crh2007530/fpga-multitimbral-instrument/FPGA/assets/ship_source.png

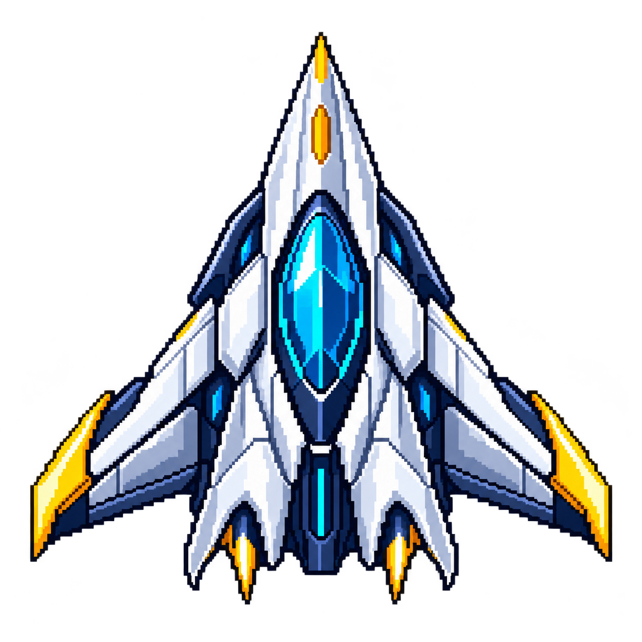
FPGA/assets/ship_source.png
