crh2007530/fpga-multitimbral-instrument/FPGA/rtl/approved_control_rom.v

module approved_control_rom(input clk,input ena,enb,input[9:0] ca,cb,pa,pb,output[31:0] qa,qb,output[15:0] pqa,pqb);
`ifdef __ICARUS__
`ifndef NATIVE_DPB
reg[31:0] curves[0:1023],ra,rb;reg[15:0] pitch[0:1023],rpa,rpb;
initial begin $readmemh("assets/approved_envelopes.hex",curves);$readmemh("assets/approved_pitch_index.hex",pitch);end
always @(posedge clk)begin if(ena)begin ra<=curves[ca];rpa<=pitch[pa];end if(enb)begin rb<=curves[cb];rpb<=pitch[pb];end end
assign qa=ra;assign qb=rb;assign pqa=rpa;assign pqb=rpb;
`else
`define APPROVED_CONTROL_NATIVE
`endif
`else
`define APPROVED_CONTROL_NATIVE
`endif
`ifdef APPROVED_CONTROL_NATIVE
DPB #(.READ_MODE0(0),.READ_MODE1(0),.BIT_WIDTH_0(16),.BIT_WIDTH_1(16),
.INIT_RAM_00(256'h40003b00370033002f002a00260022001e001900150011000d00080004000000),
.INIT_RAM_01(256'h84037f007b00770073006e006a00660062005d005900550051004c0048004400),
.INIT_RAM_02(256'hc82cc329bf27bb25b722b220ae1daa1ba618a1169d139910950e900b8c088806),
.INIT_RAM_03(256'hff4eff4cff4aff48fb46f644f242ee40ea3ee53ce139dd37d935d433d030cc2e),
.INIT_RAM_04(256'hff6bff69ff68ff66ff64ff62ff61ff5fff5dff5bff5aff58ff56ff54ff52ff50),
.INIT_RAM_05(256'hfe83fe82fe80ff7fff7dff7cff7aff79ff78ff76ff74ff73ff71ff70ff6eff6d),
.INIT_RAM_06(256'hfb97fb96fb95fb94fb92fc91fc90fc8ffc8efc8cfd8bfd8afd88fd87fe86fe84),
.INIT_RAM_07(256'hf7a8f8a7f8a6f8a5f8a4f8a3f9a2f9a1f9a0f99ff99efa9dfa9cfa9bfa99fa98),
.INIT_RAM_08(256'hf4b6f4b5f5b5f5b4f5b3f5b2f5b1f6b0f6aff6aff6aef6adf7acf7abf7aaf7a9),
.INIT_RAM_09(256'hf1c2f1c1f2c1f2c0f2bff2bff2bef3bdf3bcf3bcf3bbf3baf3b9f4b9f4b8f4b7),
.INIT_RAM_0A(256'heecceecbefcbefcaefcaefc9efc8efc8f0c7f0c7f0c6f0c5f0c5f1c4f1c3f1c3),
.INIT_RAM_0B(256'hebd4ebd4ecd3ecd3ecd2ecd2ecd1edd1edd0edd0edcfedcfedceeeceeecdeecd),
.INIT_RAM_0C(256'he8dbe9dbe9dae9dae9dae9d9ead9ead8ead8ead7ead7ead7ebd6ebd6ebd5ebd5),
.INIT_RAM_0D(256'he6e1e6e1e6e0e6e0e6e0e7dfe7dfe7dfe7dee7dee7dee8dde8dde8dce8dce8dc),
.INIT_RAM_0E(256'he3e6e3e6e3e5e3e5e4e5e4e5e4e4e4e4e4e4e5e3e5e3e5e3e5e2e5e2e5e2e6e1),
.INIT_RAM_0F(256'he0eae1eae1eae1e9e1e9e1e9e1e9e2e8e2e8e2e8e2e8e2e7e2e7e3e7e3e6e3e6),
.INIT_RAM_10(256'hc0fec2fdc4fdc6fdc8fccafbccfbcefad0f9d2f8d4f6d6f5d9f3dbf0deeee0ea),
.INIT_RAM_11(256'haaffabffacffadffafffb0ffb1ffb3ffb4ffb5ffb7ffb8febafebbfebdfebffe),
.INIT_RAM_12(256'h9bff9cff9dff9dff9eff9fffa0ffa1ffa2ffa3ffa4ffa5ffa6ffa7ffa8ffa9ff),
.INIT_RAM_13(256'h92ff92ff93ff93ff94ff94ff95ff95ff96ff96ff97ff98ff98ff99ff9aff9aff),
.INIT_RAM_14(256'h8bff8cff8cff8cff8dff8dff8dff8eff8eff8eff8fff8fff90ff90ff91ff91ff),
.INIT_RAM_15(256'h87ff87ff88ff88ff88ff88ff89ff89ff89ff89ff8aff8aff8aff8aff8bff8bff),
.INIT_RAM_16(256'h85ff85ff85ff85ff85ff85ff85ff86ff86ff86ff86ff86ff86ff87ff87ff87ff),
.INIT_RAM_17(256'h83ff83ff83ff83ff83ff83ff83ff83ff84ff84ff84ff84ff84ff84ff84ff84ff),
.INIT_RAM_18(256'h82ff82ff82ff82ff82ff82ff82ff82ff82ff82ff82ff82ff82ff83ff83ff83ff),
.INIT_RAM_19(256'h81ff81ff81ff81ff81ff81ff81ff81ff81ff81ff81ff81ff81ff81ff82ff82ff),
.INIT_RAM_1A(256'h80ff80ff80ff80ff81ff81ff81ff81ff81ff81ff81ff81ff81ff81ff81ff81ff),
.INIT_RAM_1B(256'h80ff80ff80ff80ff80ff80ff80ff80ff80ff80ff80ff80ff80ff80ff80ff80ff),
.INIT_RAM_1C(256'h80ff80ff80ff80ff80ff80ff80ff80ff80ff80ff80ff80ff80ff80ff80ff80ff),
.INIT_RAM_1D(256'h80ff80ff80ff80ff80ff80ff80ff80ff80ff80ff80ff80ff80ff80ff80ff80ff),
.INIT_RAM_1E(256'h80ff80ff80ff80ff80ff80ff80ff80ff80ff80ff80ff80ff80ff80ff80ff80ff),
.INIT_RAM_1F(256'h80ff80ff80ff80ff80ff80ff80ff80ff80ff80ff80ff80ff80ff80ff80ff80ff),
.INIT_RAM_20(256'h80ff80ff80ff80ff80ff80ff80ff80ff80ff80ff80ff80ff80ff80ff80ff80ff),
.INIT_RAM_21(256'h80ff80ff80ff80ff80ff80ff80ff80ff80ff80ff80ff80ff80ff80ff80ff80ff),
.INIT_RAM_22(256'h80ff80ff80ff80ff80ff80ff80ff80ff80ff80ff80ff80ff80ff80ff80ff80ff),
.INIT_RAM_23(256'h80ff80ff80ff80ff80ff80ff80ff80ff80ff80ff80ff80ff80ff80ff80ff80ff),
.INIT_RAM_24(256'h80ff80ff80ff80ff80ff80ff80ff80ff80ff80ff80ff80ff80ff80ff80ff80ff),
.INIT_RAM_25(256'h80ff80ff80ff80ff80ff80ff80ff80ff80ff80ff80ff80ff80ff80ff80ff80ff),
.INIT_RAM_26(256'h80ff80ff80ff80ff80ff80ff80ff80ff80ff80ff80ff80ff80ff80ff80ff80ff),
.INIT_RAM_27(256'h80ff80ff80ff80ff80ff80ff80ff80ff80ff80ff80ff80ff80ff80ff80ff80ff),
.INIT_RAM_28(256'h80ff80ff80ff80ff80ff80ff80ff80ff80ff80ff80ff80ff80ff80ff80ff80ff),
.INIT_RAM_29(256'h80ff80ff80ff80ff80ff80ff80ff80ff80ff80ff80ff80ff80ff80ff80ff80ff),
.INIT_RAM_2A(256'h80ff80ff80ff80ff80ff80ff80ff80ff80ff80ff80ff80ff80ff80ff80ff80ff),
.INIT_RAM_2B(256'h80ff80ff80ff80ff80ff80ff80ff80ff80ff80ff80ff80ff80ff80ff80ff80ff),
.INIT_RAM_2C(256'h80ff80ff80ff80ff80ff80ff80ff80ff80ff80ff80ff80ff80ff80ff80ff80ff),
.INIT_RAM_2D(256'h80ff80ff80ff80ff80ff80ff80ff80ff80ff80ff80ff80ff80ff80ff80ff80ff),
.INIT_RAM_2E(256'h80ff80ff80ff80ff80ff80ff80ff80ff80ff80ff80ff80ff80ff80ff80ff80ff),
.INIT_RAM_2F(256'h80ff80ff80ff80ff80ff80ff80ff80ff80ff80ff80ff80ff80ff80ff80ff80ff),
.INIT_RAM_30(256'h80ff80ff80ff80ff80ff80ff80ff80ff80ff80ff80ff80ff80ff80ff80ff80ff),
.INIT_RAM_31(256'h80ff80ff80ff80ff80ff80ff80ff80ff80ff80ff80ff80ff80ff80ff80ff80ff),
.INIT_RAM_32(256'h80ff80ff80ff80ff80ff80ff80ff80ff80ff80ff80ff80ff80ff80ff80ff80ff),
.INIT_RAM_33(256'h80ff80ff80ff80ff80ff80ff80ff80ff80ff80ff80ff80ff80ff80ff80ff80ff),
.INIT_RAM_34(256'h80ff80ff80ff80ff80ff80ff80ff80ff80ff80ff80ff80ff80ff80ff80ff80ff),
.INIT_RAM_35(256'h80ff80ff80ff80ff80ff80ff80ff80ff80ff80ff80ff80ff80ff80ff80ff80ff),
.INIT_RAM_36(256'h80ff80ff80ff80ff80ff80ff80ff80ff80ff80ff80ff80ff80ff80ff80ff80ff),
.INIT_RAM_37(256'h80ff80ff80ff80ff80ff80ff80ff80ff80ff80ff80ff80ff80ff80ff80ff80ff),
.INIT_RAM_38(256'h80ff80ff80ff80ff80ff80ff80ff80ff80ff80ff80ff80ff80ff80ff80ff80ff),
.INIT_RAM_39(256'h80ff80ff80ff80ff80ff80ff80ff80ff80ff80ff80ff80ff80ff80ff80ff80ff),
.INIT_RAM_3A(256'h80ff80ff80ff80ff80ff80ff80ff80ff80ff80ff80ff80ff80ff80ff80ff80ff),
.INIT_RAM_3B(256'h80ff80ff80ff80ff80ff80ff80ff80ff80ff80ff80ff80ff80ff80ff80ff80ff),
.INIT_RAM_3C(256'h80ff80ff80ff80ff80ff80ff80ff80ff80ff80ff80ff80ff80ff80ff80ff80ff),
.INIT_RAM_3D(256'h80ff80ff80ff80ff80ff80ff80ff80ff80ff80ff80ff80ff80ff80ff80ff80ff),
.INIT_RAM_3E(256'h80ff80ff80ff80ff80ff80ff80ff80ff80ff80ff80ff80ff80ff80ff80ff80ff),
.INIT_RAM_3F(256'h80ff80ff80ff80ff80ff80ff80ff80ff80ff80ff80ff80ff80ff80ff80ff80ff)) rom_lo(.DOA(qa[15:0]),.DOB(qb[15:0]),.DIA(16'd0),.DIB(16'd0),.BLKSELA(3'd0),.BLKSELB(3'd0),.ADA({ca,4'd0}),.ADB({cb,4'd0}),.WREA(1'b0),.WREB(1'b0),.CLKA(clk),.CLKB(clk),.CEA(ena),.CEB(enb),.OCEA(1'b1),.OCEB(1'b1),.RESETA(1'b0),.RESETB(1'b0));
DPB #(.READ_MODE0(0),.READ_MODE1(0),.BIT_WIDTH_0(16),.BIT_WIDTH_1(16),
.INIT_RAM_00(256'hff7fff77ff6eff66ff5dff55ff4cff44ff3bff33ff2aff22ff19ff11ff08ff00),
.INIT_RAM_01(256'hfffffffffff6ffeeffe5ffddffd4ffccffc3ffbbffb2ffaaffa1ff99ff90ff88),
.INIT_RAM_02(256'hfdfffdfffdfffdfffdfffefffefffefffefffefffefffefffeffffffffffffff),
.INIT_RAM_03(256'hfbfffbfffbfffbfffcfffcfffcfffcfffcfffcfffcfffcfffcfffdfffdfffdff),
.INIT_RAM_04(256'hf9fdf9fdf9fdf9fdfafdfafdfafefafefafefafefafefafefbfefbfefbfefbff),
.INIT_RAM_05(256'hf7fbf7fbf7fbf8fcf8fcf8fcf8fcf8fcf8fcf8fcf8fcf9fcf9fdf9fdf9fdf9fd),
.INIT_RAM_06(256'hf5faf5faf6faf6faf6faf6faf6faf6faf6faf6faf7fbf7fbf7fbf7fbf7fbf7fb),
.INIT_RAM_07(256'hf4f8f4f8f4f8f4f8f4f8f4f8f4f8f4f9f4f9f5f9f5f9f5f9f5f9f5f9f5f9f5f9),
.INIT_RAM_08(256'hf2f6f2f6f2f6f2f6f2f7f2f7f2f7f2f7f3f7f3f7f3f7f3f7f3f7f3f7f3f8f3f8),
.INIT_RAM_09(256'hf0f4f0f5f0f5f0f5f0f5f0f5f1f5f1f5f1f5f1f5f1f5f1f6f1f6f1f6f1f6f2f6),
.INIT_RAM_0A(256'heef3eef3eef3eef3eef3eff3eff3eff4eff4eff4eff4eff4eff4eff4f0f4f0f4),
.INIT_RAM_0B(256'hecf1ecf1ecf1edf1edf2edf2edf2edf2edf2edf2edf2edf2eef2eef2eef3eef3),
.INIT_RAM_0C(256'heaf0ebf0ebf0ebf0ebf0ebf0ebf0ebf0ebf0ebf0ecf1ecf1ecf1ecf1ecf1ecf1),
.INIT_RAM_0D(256'he9eee9eee9eee9eee9eee9eee9eee9efeaefeaefeaefeaefeaefeaefeaefeaef),
.INIT_RAM_0E(256'he7ece7ece7ece7ede7ede7ede8ede8ede8ede8ede8ede8ede8ede8eee8eee9ee),
.INIT_RAM_0F(256'he5ebe5ebe5ebe5ebe6ebe6ebe6ebe6ebe6ebe6ece6ece6ece6ece7ece7ece7ec),
.INIT_RAM_10(256'hccd4ced5cfd7d1d8d3dad4dbd6ddd7ded9e0dbe1dce3dee4e0e6e2e7e3e9e5eb),
.INIT_RAM_11(256'hb5bfb6c0b8c1b9c2bac4bcc5bdc6bfc8c0c9c2cac3ccc5cdc6cec8d0c9d1cbd3),
.INIT_RAM_12(256'ha0aca1ada3aea4afa5b0a6b1a8b3a9b4aab5abb6adb7aeb8afbab1bbb2bcb4bd),
.INIT_RAM_13(256'h8e9b8f9c909d919e929f93a094a196a297a398a499a59aa69ba79da89ea99fab),
.INIT_RAM_14(256'h7e8c7e8d7f8e808f819082918391849285938694879588968a978b988c998d9a),
.INIT_RAM_15(256'h6f7f708071817281738273837484758576857786788779887a897b8a7c8a7d8b),
.INIT_RAM_16(256'h627363746475657565766677677868786979697a6a7a6b7b6c7c6d7d6d7d6e7e),
.INIT_RAM_17(256'h5769586a586a596b5a6b5a6c5b6d5c6d5d6e5d6f5e6f5f705f71607161726273),
.INIT_RAM_18(256'h4d604e604e614f624f6250635163516452645365536554665467556756685668),
.INIT_RAM_19(256'h4458455845594659465a475a475b485b495c495c4a5d4a5d4b5e4b5e4c5f4d5f),
.INIT_RAM_1A(256'h3c513d513d523e523e523f533f53405440544155415542564256435643574457),
.INIT_RAM_1B(256'h364a364b364b374b374c384c384d384d394d394e3a4e3a4f3b4f3b4f3c503c50),
.INIT_RAM_1C(256'h2f453045304530463146314632473247324733483348344934493449354a354a),
.INIT_RAM_1D(256'h2a402a402b402b412b412c412c422c422d422d432d432e432e432e442f442f44),
.INIT_RAM_1E(256'h253b253c263c263c263c273d273d273d273e283e283e283e293f293f293f2a40),
.INIT_RAM_1F(256'h213821382138223822382239223923392339233a233a243a243a243b253b253b),
.INIT_RAM_20(256'h1d341d341e341e351e351e351e351f361f361f361f3620362037203720372137),
.INIT_RAM_21(256'h1a311a311a311a321b321b321b321b321b331c331c331c331c331c331d341d34),
.INIT_RAM_22(256'h172e172e172f172f182f182f182f182f18301830193019301930193019311a31),
.INIT_RAM_23(256'h142c142c152c152c152d152d152d152d152d162d162d162e162e162e162e172e),
.INIT_RAM_24(256'h122a122a122a122a122a132a132b132b132b132b132b132b142b142c142c142c),
.INIT_RAM_25(256'h10281028102810281028102911291129112911291129112911291129122a122a),
.INIT_RAM_26(256'h0e260e260e260e270e270f270f270f270f270f270f270f270f280f2810281028),
.INIT_RAM_27(256'h0c250d250d250d250d250d250d250d250d260d260d260d260e260e260e260e26),
.INIT_RAM_28(256'h0b240b240b240b240b240b240c240c240c240c240c240c240c240c250c250c25),
.INIT_RAM_29(256'h0a220a220a230a230a230a230a230a230a230a230a230b230b230b230b230b23),
.INIT_RAM_2A(256'h09210921092109220922092209220922092209220922092209220a220a220a22),
.INIT_RAM_2B(256'h0820082108210821082108210821082108210821082108210821082108210921),
.INIT_RAM_2C(256'h0720072007200720072007200720072007200720072007200720072008200820),
.INIT_RAM_2D(256'h061f061f061f061f061f061f061f061f061f061f061f061f071f072007200720),
.INIT_RAM_2E(256'h051e051e051e051e051e051f061f061f061f061f061f061f061f061f061f061f),
.INIT_RAM_2F(256'h051e051e051e051e051e051e051e051e051e051e051e051e051e051e051e051e),
.INIT_RAM_30(256'h041d041d041d041d041d041d041d041d041e041e041e051e051e051e051e051e),
.INIT_RAM_31(256'h041d041d041d041d041d041d041d041d041d041d041d041d041d041d041d041d),
.INIT_RAM_32(256'h031c031c031d031d031d031d031d031d031d031d041d041d041d041d041d041d),
.INIT_RAM_33(256'h031c031c031c031c031c031c031c031c031c031c031c031c031c031c031c031c),
.INIT_RAM_34(256'h031c031c031c031c031c031c031c031c031c031c031c031c031c031c031c031c),
.INIT_RAM_35(256'h021c021c021c021c021c021c021c021c021c021c021c021c021c021c031c031c),
.INIT_RAM_36(256'h021b021b021b021b021b021b021b021b021b021b021b021b021b021c021c021c),
.INIT_RAM_37(256'h021b021b021b021b021b021b021b021b021b021b021b021b021b021b021b021b),
.INIT_RAM_38(256'h021b021b021b021b021b021b021b021b021b021b021b021b021b021b021b021b),
.INIT_RAM_39(256'h011b011b011b011b011b011b011b011b011b011b011b021b021b021b021b021b),
.INIT_RAM_3A(256'h011b011b011b011b011b011b011b011b011b011b011b011b011b011b011b011b),
.INIT_RAM_3B(256'h011a011a011b011b011b011b011b011b011b011b011b011b011b011b011b011b),
.INIT_RAM_3C(256'h011a011a011a011a011a011a011a011a011a011a011a011a011a011a011a011a),
.INIT_RAM_3D(256'h011a011a011a011a011a011a011a011a011a011a011a011a011a011a011a011a),
.INIT_RAM_3E(256'h011a011a011a011a011a011a011a011a011a011a011a011a011a011a011a011a),
.INIT_RAM_3F(256'h011a011a011a011a011a011a011a011a011a011a011a011a011a011a011a011a)) rom_hi(.DOA(qa[31:16]),.DOB(qb[31:16]),.DIA(16'd0),.DIB(16'd0),.BLKSELA(3'd0),.BLKSELB(3'd0),.ADA({ca,4'd0}),.ADB({cb,4'd0}),.WREA(1'b0),.WREB(1'b0),.CLKA(clk),.CLKB(clk),.CEA(ena),.CEB(enb),.OCEA(1'b1),.OCEB(1'b1),.RESETA(1'b0),.RESETB(1'b0));
DPB #(.READ_MODE0(0),.READ_MODE1(0),.BIT_WIDTH_0(16),.BIT_WIDTH_1(16),
.INIT_RAM_00(256'h020502300263029e02e4033a03a3042804d405bc070208ea0c0d120c21507c80),
.INIT_RAM_01(256'h00dd00e600ef00f901040110011d012b013a014b015d0172018901a201bf01e0),
.INIT_RAM_02(256'h0087008a008e00920096009a009f00a300a800ae00b300b900bf00c600cd00d5),
.INIT_RAM_03(256'h005f00610063006500670069006b006e0070007200750078007a007d00800084),
.INIT_RAM_04(256'h0049004a004b004c004d004f0050005100530054005500570059005a005c005d),
.INIT_RAM_05(256'h003a003b003c003d003d003e003f004000410042004300440045004600470048),
.INIT_RAM_06(256'h003000310032003200330033003400340035003600360037003800380039003a),
.INIT_RAM_07(256'h0029002a002a002a002b002b002c002c002d002d002e002e002e002f002f0030),
.INIT_RAM_08(256'h0024002400240025002500250026002600260027002700270028002800280029),
.INIT_RAM_09(256'h0020002000200020002100210021002100220022002200220023002300230024),
.INIT_RAM_0A(256'h001c001c001d001d001d001d001d001e001e001e001e001e001f001f001f001f),
.INIT_RAM_0B(256'h00190019001a001a001a001a001a001a001b001b001b001b001b001c001c001c),
.INIT_RAM_0C(256'h0017001700170017001800180018001800180018001800190019001900190019),
.INIT_RAM_0D(256'h0015001500150015001600160016001600160016001600160016001700170017),
.INIT_RAM_0E(256'h0013001300140014001400140014001400140014001400140015001500150015),
.INIT_RAM_0F(256'h0012001200120012001200120012001300130013001300130013001300130013),
.INIT_RAM_10(256'h0011001100110011001100110011001100110011001100120012001200120012),
.INIT_RAM_11(256'h0010001000100010001000100010001000100010001000100010001000110011),
.INIT_RAM_12(256'h000f000f000f000f000f000f000f000f000f000f000f000f000f000f000f000f),
.INIT_RAM_13(256'h000e000e000e000e000e000e000e000e000e000e000e000e000e000e000e000f),
.INIT_RAM_14(256'h000d000d000d000d000d000d000d000d000d000d000d000d000d000e000e000e),
.INIT_RAM_15(256'h000c000c000c000c000c000c000c000d000d000d000d000d000d000d000d000d),
.INIT_RAM_16(256'h000c000c000c000c000c000c000c000c000c000c000c000c000c000c000c000c),
.INIT_RAM_17(256'h000b000b000b000b000b000b000b000b000b000b000b000b000b000b000c000c),
.INIT_RAM_18(256'h000a000b000b000b000b000b000b000b000b000b000b000b000b000b000b000b),
.INIT_RAM_19(256'h000a000a000a000a000a000a000a000a000a000a000a000a000a000a000a000a),
.INIT_RAM_1A(256'h000a000a000a000a000a000a000a000a000a000a000a000a000a000a000a000a),
.INIT_RAM_1B(256'h00090009000900090009000900090009000900090009000900090009000a000a),
.INIT_RAM_1C(256'h0009000900090009000900090009000900090009000900090009000900090009),
.INIT_RAM_1D(256'h0008000800080008000900090009000900090009000900090009000900090009),
.INIT_RAM_1E(256'h0008000800080008000800080008000800080008000800080008000800080008),
.INIT_RAM_1F(256'h0008000800080008000800080008000800080008000800080008000800080008),
.INIT_RAM_20(256'h0008000800080008000800080008000800080008000800080008000800080008),
.INIT_RAM_21(256'h0007000700070007000700070007000700070007000700070007000700070007),
.INIT_RAM_22(256'h0007000700070007000700070007000700070007000700070007000700070007),
.INIT_RAM_23(256'h0007000700070007000700070007000700070007000700070007000700070007),
.INIT_RAM_24(256'h0007000700070007000700070007000700070007000700070007000700070007),
.INIT_RAM_25(256'h0006000600060006000600060006000600060006000600060006000700070007),
.INIT_RAM_26(256'h0006000600060006000600060006000600060006000600060006000600060006),
.INIT_RAM_27(256'h0006000600060006000600060006000600060006000600060006000600060006),
.INIT_RAM_28(256'h0006000600060006000600060006000600060006000600060006000600060006),
.INIT_RAM_29(256'h0006000600060006000600060006000600060006000600060006000600060006),
.INIT_RAM_2A(256'h0005000500050005000600060006000600060006000600060006000600060006),
.INIT_RAM_2B(256'h0005000500050005000500050005000500050005000500050005000500050005),
.INIT_RAM_2C(256'h0005000500050005000500050005000500050005000500050005000500050005),
.INIT_RAM_2D(256'h0005000500050005000500050005000500050005000500050005000500050005),
.INIT_RAM_2E(256'h0005000500050005000500050005000500050005000500050005000500050005),
.INIT_RAM_2F(256'h0005000500050005000500050005000500050005000500050005000500050005),
.INIT_RAM_30(256'h0005000500050005000500050005000500050005000500050005000500050005),
.INIT_RAM_31(256'h0005000500050005000500050005000500050005000500050005000500050005),
.INIT_RAM_32(256'h0004000400040004000400040004000400050005000500050005000500050005),
.INIT_RAM_33(256'h0004000400040004000400040004000400040004000400040004000400040004),
.INIT_RAM_34(256'h0004000400040004000400040004000400040004000400040004000400040004),
.INIT_RAM_35(256'h0004000400040004000400040004000400040004000400040004000400040004),
.INIT_RAM_36(256'h0004000400040004000400040004000400040004000400040004000400040004),
.INIT_RAM_37(256'h0004000400040004000400040004000400040004000400040004000400040004),
.INIT_RAM_38(256'h0004000400040004000400040004000400040004000400040004000400040004),
.INIT_RAM_39(256'h0004000400040004000400040004000400040004000400040004000400040004),
.INIT_RAM_3A(256'h0004000400040004000400040004000400040004000400040004000400040004),
.INIT_RAM_3B(256'h0004000400040004000400040004000400040004000400040004000400040004),
.INIT_RAM_3C(256'h0004000400040004000400040004000400040004000400040004000400040004),
.INIT_RAM_3D(256'h0004000400040004000400040004000400040004000400040004000400040004),
.INIT_RAM_3E(256'h0003000300030003000300030003000300030003000300030004000400040004),
.INIT_RAM_3F(256'h0003000300030003000300030003000300030003000300030003000300030003)) rom_pitch(.DOA(pqa),.DOB(pqb),.DIA(16'd0),.DIB(16'd0),.BLKSELA(3'd0),.BLKSELB(3'd0),.ADA({pa,4'd0}),.ADB({pb,4'd0}),.WREA(1'b0),.WREB(1'b0),.CLKA(clk),.CLKB(clk),.CEA(ena),.CEB(enb),.OCEA(1'b1),.OCEB(1'b1),.RESETA(1'b0),.RESETB(1'b0));
`undef APPROVED_CONTROL_NATIVE
`endif
endmodule
