crh2007530/fpga-multitimbral-instrument/FPGA/rtl/approved_wave_rom.v

// Exact dual-port oscillator table, generated from approved_oscillators.hex.
module approved_wave_rom(input clk, input ena,enb,input[12:0] addra,addrb,output[15:0] qa,qb);
`ifdef __ICARUS__
`ifndef NATIVE_DPB
reg[15:0] mem[0:8191],ra,rb;
initial $readmemh("assets/approved_oscillators.hex",mem);
always @(posedge clk)begin if(ena)ra<=mem[addra];if(enb)rb<=mem[addrb];end
assign qa=ra;assign qb=rb;
`else
`define APPROVED_NATIVE_ROM
`endif
`else
`define APPROVED_NATIVE_ROM
`endif
`ifdef APPROVED_NATIVE_ROM
wire[15:0] a[0:7],b[0:7];reg[2:0] sa,sb;
always @(posedge clk)begin if(ena)sa<=addra[12:10];if(enb)sb<=addrb[12:10];end
assign qa=a[sa];assign qb=b[sb];
DPB #( .READ_MODE0(0),.READ_MODE1(0),.BIT_WIDTH_0(16),.BIT_WIDTH_1(16),
.INIT_RAM_00(256'h0000000000000000000000000000000000000000000000000000000000000000),
.INIT_RAM_01(256'h0000000000000000000000000000000000000000000000000000000000000000),
.INIT_RAM_02(256'h0000000000000000000000000000000000000000000000000000000000000000),
.INIT_RAM_03(256'h0000000000000000000000000000000000000000000000000000000000000000),
.INIT_RAM_04(256'h0000000000000000000000000000000000000000000000000000000000000000),
.INIT_RAM_05(256'h0000000000000000000000000000000000000000000000000000000000000000),
.INIT_RAM_06(256'h0000000000000000000000000000000000000000000000000000000000000000),
.INIT_RAM_07(256'h0000000000000000000000000000000000000000000000000000000000000000),
.INIT_RAM_08(256'h0000000000000000000000000000000000000000000000000000000000000000),
.INIT_RAM_09(256'h0000000000000000000000000000000000000000000000000000000000000000),
.INIT_RAM_0A(256'h0000000000000000000000000000000000000000000000000000000000000000),
.INIT_RAM_0B(256'h0000000000000000000000000000000000000000000000000000000000000000),
.INIT_RAM_0C(256'h0000000000000000000000000000000000000000000000000000000000000000),
.INIT_RAM_0D(256'h0000000000000000000000000000000000000000000000000000000000000000),
.INIT_RAM_0E(256'h0000000000000000000000000000000000000000000000000000000000000000),
.INIT_RAM_0F(256'h0000000000000000000000000000000000000000000000000000000000000000),
.INIT_RAM_10(256'h0000000000000000000000000000000000000000000000000000000000000000),
.INIT_RAM_11(256'h0000000000000000000000000000000000000000000000000000000000000000),
.INIT_RAM_12(256'h0000000000000000000000000000000000000000000000000000000000000000),
.INIT_RAM_13(256'h0000000000000000000000000000000000000000000000000000000000000000),
.INIT_RAM_14(256'h0000000000000000000000000000000000000000000000000000000000000000),
.INIT_RAM_15(256'h0000000000000000000000000000000000000000000000000000000000000000),
.INIT_RAM_16(256'h0000000000000000000000000000000000000000000000000000000000000000),
.INIT_RAM_17(256'h0000000000000000000000000000000000000000000000000000000000000000),
.INIT_RAM_18(256'h0000000000000000000000000000000000000000000000000000000000000000),
.INIT_RAM_19(256'h0000000000000000000000000000000000000000000000000000000000000000),
.INIT_RAM_1A(256'h0000000000000000000000000000000000000000000000000000000000000000),
.INIT_RAM_1B(256'h0000000000000000000000000000000000000000000000000000000000000000),
.INIT_RAM_1C(256'h0000000000000000000000000000000000000000000000000000000000000000),
.INIT_RAM_1D(256'h0000000000000000000000000000000000000000000000000000000000000000),
.INIT_RAM_1E(256'h0000000000000000000000000000000000000000000000000000000000000000),
.INIT_RAM_1F(256'h0000000000000000000000000000000000000000000000000000000000000000),
.INIT_RAM_20(256'hd130cd60c9d3c693c3aac11fbef6bd31bbcababcb9fcb97eb934b913b90fb91e),
.INIT_RAM_21(256'h11be0f120bfc088c04d000d7fcaff864f400ef8deb11e695e220ddb8d967d536),
.INIT_RAM_22(256'h039d05ee084d0ab10d0e0f57117b1368150c16561734179b177e16da15ab13f5),
.INIT_RAM_23(256'he7aee8eeea4febc9ed56eef0f093f23ff3f2f5aef775f949fb2ffd29ff380160),
.INIT_RAM_24(256'hfcdcf95bf5f8f2c0efc4ed12eab6e8bae723e5f5e52fe4cde4cae51de5bbe699),
.INIT_RAM_25(256'h256b2465232321a41feb1df91bd2197616e6142511360e1a0ad6077103f40069),
.INIT_RAM_26(256'h1b4e1cee1e741fe1213322692383247e2558260b269426ef2716270626ba2632),
.INIT_RAM_27(256'h0131020a03110444059d071a08b80a720c430e271016120b13ff15eb17c91996),
.INIT_RAM_28(256'h1a7317601437110f0e000b1f087f062f043902a40171009e0025ffff0025008e),
.INIT_RAM_29(256'h2c192c112bf42bc72b8b2b3e2adb2a5929ad28cc27aa263d247f226d20091d5c),
.INIT_RAM_2A(256'h149b172d19b31c261e7f20b722c824ac265c27d529142a172adf2b712bd12c06),
.INIT_RAM_2B(256'h03dd0278016700b0005b006a00de01b302e6046d063e084d0a8e0cf50f761206),
.INIT_RAM_2C(256'h2eac2c2429612672236520491d2a1a13170c141b11480e960c0b09ac077f058d),
.INIT_RAM_2D(256'h30ae31d332e133dc34c0358c363a36c03716372f3700368035a7347032db30ed),
.INIT_RAM_2E(256'h1be41c271cae1d781e7f1fbc212922b92462261927d229832b232cac2e1c2f72),
.INIT_RAM_2F(256'h40853cc438e7350b31492db82a6a276c24c6227c208f1efb1dbe1cd31c381be9),
.INIT_RAM_30(256'h436545d848174a214bf04d7a4eb34f8b4ff44fde4f404e114c524a094740440c),
.INIT_RAM_31(256'h05e709a60d9e11c716171a801ef5236527c22bfb300633d9376f3ac63ddf40be),
.INIT_RAM_32(256'hf0c5efcbef0dee97ee73eea7ef34f01cf15bf2edf4cff6fbf96ffc28ff260266),
.INIT_RAM_33(256'hfb21fb71fb9afba0fb87fb4efaf3fa75f9d0f903f80ff6f6f5c1f479f32cf1eb),
.INIT_RAM_34(256'he54ce5f1e6dfe818e997eb51ed35ef31f12ff31cf4e7f683f7e5f90bf9f4faa4),
.INIT_RAM_35(256'hd8bed9c6db0cdc7dddfedf79e0d6e205e2f8e3ade424e467e488e499e4b1e4e6),
.INIT_RAM_36(256'he955e7fae68ee50fe37be1d6e027de77dcd4db4fd9fad8e4d81fd7b5d7acd807),
.INIT_RAM_37(256'h002fff20fde8fc8afb0df97cf7ddf63af49bf305f17df006ee9fed45ebf4eaa7),
.INIT_RAM_38(256'h0899078b068b05a604e5044c03db038b03570331030f02e402a5024601c0010f),
.INIT_RAM_39(256'hf575f87afb8efe99018204310690088e0a1e0b380bdd0c110be10b5c0a9609a3),
.INIT_RAM_3A(256'hdc7fde26df99e0dae1f1e2e7e3cce4b1e5a6e6bee809e992eb64ed82efe9f294),
.INIT_RAM_3B(256'hcd27cbd1cac3ca0dc9bbc9d4ca5bcb4acc9ace3bd01ed22ed457d684d8a4daa6),
.INIT_RAM_3C(256'hdd42dcabdc2edbc2db5adaebda66d9c0d8edd7e9d6b1d549d3b9d20fd05bceb1),
.INIT_RAM_3D(256'he8dde8e4e8cee898e83ce7b8e70ce639e545e436e317e1f3e0d4dfc5decfddf8),
.INIT_RAM_3E(256'hd39dd69ed977dc17de74e087e24fe3cbe503e5fee6c6e763e7dee83fe888e8bd),
.INIT_RAM_3F(256'hb93db96ab9a7b9feba76bb1cbbfbbd20be92c056c26ec4d4c77fca61cd6ad084)) rom0(.DOA(a[0]),.DOB(b[0]),.DIA(16'd0),.DIB(16'd0),
.BLKSELA(3'd0),.BLKSELB(3'd0),.ADA({addra[9:0],4'd0}),.ADB({addrb[9:0],4'd0}),
.WREA(1'b0),.WREB(1'b0),.CLKA(clk),.CLKB(clk),.CEA(ena && addra[12:10]==3'd0),.CEB(enb && addrb[12:10]==3'd0),
.OCEA(1'b1),.OCEB(1'b1),.RESETA(1'b0),.RESETB(1'b0));
DPB #( .READ_MODE0(0),.READ_MODE1(0),.BIT_WIDTH_0(16),.BIT_WIDTH_1(16),
.INIT_RAM_00(256'hc2d4be16b9a1b581b1c0ae66ab76a8f2a6d9a523a3c9a2c0a1fda176a121a0f9),
.INIT_RAM_01(256'h14f311660d5308cf03edfec3f963f3dfee44e89fe2fadd5dd7cfd258cd00c7d1),
.INIT_RAM_02(256'h09270b860deb105212b51507173619301adf1c2a1cfc1d411ce91beb1a4017eb),
.INIT_RAM_03(256'he242e415e62de87feafbed95f040f2f0f59cf83dfacefd4dffbc021d047706ce),
.INIT_RAM_04(256'hfac8f6ddf314ef7aec1be905e644e3e3e1ebe064df51deb6de91dee0df9de0c1),
.INIT_RAM_05(256'h3352315f2f062c51294c260422841ed81b0b172313290f200b0d06f502ddfecc),
.INIT_RAM_06(256'h24a226f0291f2b332d2d2f0a30c8326133cb34fb35e6367e36b7368835e934d7),
.INIT_RAM_07(256'hff7e007601bd0350052b074909a30c2e0ee211b0148d176b1a401d021fab2236),
.INIT_RAM_08(256'h21571d4a192e151e11360d8d0a37074304bb02a400ffffc8fefbfe93fe89fed9),
.INIT_RAM_09(256'h37a43801383b3856384f382237c6372e364e3518337e31792f042c2128d92539),
.INIT_RAM_0A(256'h145e17941ad81e1e2158247927762a412cd22f1f312532e13452357e366b371f),
.INIT_RAM_0B(256'h073f057b03fc02cb01ef0171015601a4025a037904fb06db09100b900e4f1143),
.INIT_RAM_0C(256'h3d4039b935df31cc2d9c29692548214c1d8019ed1696137a10990def0b7d0941),
.INIT_RAM_0D(256'h3dfb3f3c407a41b942f844314559465e472b47aa47c44765467d450342f6405b),
.INIT_RAM_0E(256'h271a273e27c428a629db2b572d0b2ee630d732cd34b9368e384539db3b523caf),
.INIT_RAM_0F(256'h550d50dc4c7c480b43a73f683b6337a9344631402e9d2c5d2a8429102802275b),
.INIT_RAM_10(256'h58615b0e5d715f90616b62fe643e651f6590658164e463ae61db5f6d5c6f58f2),
.INIT_RAM_11(256'h06840b7c10d9168d1c8522aa28e22f11351b3ae5405a456c4a0f4e4152045561),
.INIT_RAM_12(256'hec52eb8beaf9eaa8eaa1eaeceb8eec89eddfef92f1a4f417f6eefa2efddb01f8),
.INIT_RAM_13(256'hf71cf72ff713f6d0f670f5faf56ff4d0f41cf352f271f17af071ef5eee4aed41),
.INIT_RAM_14(256'hdcefdddddf1ae0abe28de4b4e70fe984ebfaee57f084f26df406f547f632f6cb),
.INIT_RAM_15(256'hc7ddc92fcae4cce1cf09d13bd35bd54dd6fed863d97ada49dae0db55dbc2dc43),
.INIT_RAM_16(256'he214dfc0dd5fdaefd870d5e8d35ed0dfce7bcc46ca54c8bac78bc6d8c6a8c701),
.INIT_RAM_17(256'h04ff037a01bdffd1fdbcfb89f93ff6e7f489f22aefcfed7aeb2de8e6e6a2e45e),
.INIT_RAM_18(256'h0b170a7b09f4098c09450920091709200931093b0930090508ac081d07520648),
.INIT_RAM_19(256'hf60ef95dfca3ffc902bb056607b809a60b280c3c0ce50d2e0d220cd30c550bba),
.INIT_RAM_1A(256'hd3e8d5e9d7bad963daefdc6bdde8df74e120e2f7e505e750e9daeca1ef9ff2c8),
.INIT_RAM_1B(256'hbe7ebd1abc17bb88bb7abbf0bceabe5ec03cc270c4e4c77fca28cccacf53d1b5),
.INIT_RAM_1C(256'hd32cd218d12fd066cfb0cefcce39cd56cc46cb01c983c7d2c5f7c403c20dc02d),
.INIT_RAM_1D(256'he3cbe443e480e47be42fe397e2b6e18ee028de90dcd5db09d93cd781d5e4d470),
.INIT_RAM_1E(256'hc396c730ca9fcdd9d0d4d38cd600d833da2adbebdd7ddee6e02ae14be249e320),
.INIT_RAM_1F(256'ha0fba127a182a212a2dfa3f5a55aa717a930aba5ae71b18cb4e9b879bc28bfe3),
.INIT_RAM_20(256'hd569d12ecd28c962c5e4c2b5bfdbbd59bb2fb95db7e0b6b3b5d1b535b4dab4ba),
.INIT_RAM_21(256'h174a14af11b30e610ac306e302cbfe86fa1bf594f0f8ec4fe7a1e2f6de58d9d0),
.INIT_RAM_22(256'h0d540f9f11df140b161c180619be1b381c681d411dba1dc81d651c8d1b3f197d),
.INIT_RAM_23(256'hf14ff20af2f4f40bf54df6b9f84cfa02fbd8fdccffd801f9042c066c08b60b05),
.INIT_RAM_24(256'hffacfda7fbb1f9d0f80cf66cf4f5f3acf295f1b3f107f090f04ff043f06af0c4),
.INIT_RAM_25(256'h1d061bb81a4418b217061547137911a00fbd0dd20bdf09e407e105d803ca01b9),
.INIT_RAM_26(256'h1bb11c9e1d741e351ee31f7d2001206c20ba20e620ea20c220681fdc1f1c1e28),
.INIT_RAM_27(256'h0565068b07cc09250a950c190dab0f4710e612811413159417011854198e1aac),
.INIT_RAM_28(256'h03ff0325025c01ac011900aa0061003f0047007600ca014301dc029303680459),
.INIT_RAM_29(256'h142c130211d110a10f780e5b0d4b0c490b520a64097a089107a806bc05d004e4),
.INIT_RAM_2A(256'h105c11ec135c14a715cb16c3178d1824188518ae189d185417d4172216461546),
.INIT_RAM_2B(256'hfafafadbfb08fb80fc41fd46fe89000201a7036f054d073809260b0e0ce80eae),
.INIT_RAM_2C(256'h1ba918e6160c132910490d790ac3083205cc0398019bffdafe57fd16fc1afb65),
.INIT_RAM_2D(256'h2a912b132b6e2ba32bb12b952b4d2ad32a232937280b269c24e722ef20b81e48),
.INIT_RAM_2E(256'h1bd11bbd1bf11c6a1d221e111f2f206f21c52325248125d027082821291729e7),
.INIT_RAM_2F(256'h3da63ab0379f348531732e782b9f28f3267b243d223c207c1eff1dc71cd61c2f),
.INIT_RAM_30(256'h3aff3e1c40ea43644582473f4894497a49ed49e7496848704704452d42f6406e),
.INIT_RAM_31(256'hf9c2fcdb0048040308040c4010aa153619d41e74230827832bd82ffd33e93797),
.INIT_RAM_32(256'hf36cf220f0e1efc0eec9ee08ed86ed4bed5bedbbee6def75f0d2f288f497f700),
.INIT_RAM_33(256'hf2eef440f576f68ef784f852f8f4f962f998f991f94af8c6f806f712f5f4f4b8),
.INIT_RAM_34(256'hdbc5dc57dd1ede1adf4ae0aae233e3dce59be767e935eafeecbcee69f001f184),
.INIT_RAM_35(256'hdb79db5bdb4edb4ddb53db5bdb62db62db5adb4bdb37db22db13db13db2adb63),
.INIT_RAM_36(256'he7aee675e54ae42de31de21be127e042df6cdea6ddf2dd51dcc6dc50dbf2dbab),
.INIT_RAM_37(256'h04f602a9005efe1afbe4f9bef7adf5b3f3d1f206f052eeb4ed2aebb2ea4ce8f5),
.INIT_RAM_38(256'h217a20481ef21d831c011a6f18d01724156a139f11c10fcf0dc70bab097c073e),
.INIT_RAM_39(256'h0aa30e3711ac14f418031acd1d461f64211f2274235f23e5240823d1234b227f),
.INIT_RAM_3A(256'hda93dc83de9be0dbe344e5d6e890eb74ee7ff1b0f504f877fc03ffa3034e06fc),
.INIT_RAM_3B(256'hda06d817d65ad4dad3a0d2b2d214d1c6d1c6d211d2a2d373d47ed5bed72fd8cc),
.INIT_RAM_3C(256'hf636f511f3dbf293f138efc7ee3eec9aead8e8f7e6f9e4e2e2b6e07fde47dc1a),
.INIT_RAM_3D(256'hf6b1f7d5f8d4f9aefa61faeafb49fb7cfb82fb5bfb08fa8bf9e9f924f842f747),
.INIT_RAM_3E(256'hd17ad484d790da96dd8ce06ce330e5d3e852eaa8ecd7eedcf0b9f26ff3fff56a),
.INIT_RAM_3F(256'hb4d2b520b5a2b657b740b85eb9b1bb3bbcfcbef2c11ec37ac604c8b7cb8bce79)) rom1(.DOA(a[1]),.DOB(b[1]),.DIA(16'd0),.DIB(16'd0),
.BLKSELA(3'd0),.BLKSELB(3'd0),.ADA({addra[9:0],4'd0}),.ADB({addrb[9:0],4'd0}),
.WREA(1'b0),.WREB(1'b0),.CLKA(clk),.CLKB(clk),.CEA(ena && addra[12:10]==3'd1),.CEB(enb && addrb[12:10]==3'd1),
.OCEA(1'b1),.OCEB(1'b1),.RESETA(1'b0),.RESETB(1'b0));
DPB #( .READ_MODE0(0),.READ_MODE1(0),.BIT_WIDTH_0(16),.BIT_WIDTH_1(16),
.INIT_RAM_00(256'hd77ed3bdd030ccdbc9c4c6efc45fc213c00dbe4bbcc9bb87ba81b9b4b91eb8bf),
.INIT_RAM_01(256'h13bc11370e670b5107fc046f00b0fcc8f8bcf497f05fec1ee7dbe3a1df78db6a),
.INIT_RAM_02(256'h105a1263144e161317aa190b1a2d1b0a1b9a1bd81bc01b4d1a7f195417ce15f0),
.INIT_RAM_03(256'hef5cf0dcf284f44cf631f82efa3efc5efe8c00c303010544078909cc0c080e39),
.INIT_RAM_04(256'hf995f70bf4adf283f095eee8ed81ec66eb97eb16eae4eafdeb5fec05ecebee0a),
.INIT_RAM_05(256'h21e420661eac1cba1a95184215c71328106c0d9a0ab607c904d901eeff0ffc44),
.INIT_RAM_06(256'h196c1b461d091eaf2034219122c223c2248c251d256f2581254f24da24202323),
.INIT_RAM_07(256'hfed3ff9d009701bf030f0486061f07d509a40b880d7b0f79117e138415861780),
.INIT_RAM_08(256'h09ca0870070e05ab0450030401ce00b5ffc0fef3fe55fde7fdacfda6fdd6fe3a),
.INIT_RAM_09(256'h12d512da12d312bf129d126a122511cb115810cb10210f590e720d6e0c4e0b16),
.INIT_RAM_0A(256'h0ae20bbf0c970d670e2d0ee70f92102f10ba1135119f11f71240127a12a512c3),
.INIT_RAM_0B(256'h0477040603ba0393039003af03ee044b04c4055505fc06b4077a084c09260a03),
.INIT_RAM_0C(256'h1890173615c9144d12c8113e0fb50e320cba0b5209ff08c407a606a605c8050e),
.INIT_RAM_0D(256'h213c214b214a2138211520e12099203d1fca1f401e9d1de01d071c121b0119d5),
.INIT_RAM_0E(256'h1fc61f491ef31ebf1eac1eb51ed51f091f4a1f941fe22030207a20bc20f3211f),
.INIT_RAM_0F(256'h38da370a351d331e31182f132d172b2d295927a3260d249c235222312139206b),
.INIT_RAM_10(256'h329b3516375939603b243ca03dd13eb23f403f7b3f623ef83e413d413c003a85),
.INIT_RAM_11(256'hfeee01d904f0082a0b810eed126815e919691ce3205023aa26ec2a112d132fed),
.INIT_RAM_12(256'hee73ee29edf4eddaede2ee11ee6eeeffefc8f0cdf212f398f560f769f9b1fc34),
.INIT_RAM_13(256'hf360f36bf35ef33df30af2c8f27af221f1c1f15af0eef07ff00eef9fef32eecd),
.INIT_RAM_14(256'he888e955ea27eaffebddecbfeda3ee84ef5ef02df0ecf196f228f2a0f2fcf33c),
.INIT_RAM_15(256'hd739d843d96edaafdbfedd52dea2dfe8e11fe244e355e452e53ee61be6efe7bc),
.INIT_RAM_16(256'he42ce1e7dfc3ddc3dbedda44d8cdd78dd687d5c0d539d4f4d4f1d52dd5a7d657),
.INIT_RAM_17(256'h0ea40c5209dd0749049c01dcff0ffc3af962f68cf3bef0f9ee42eb9ce90ae68e),
.INIT_RAM_18(256'h1bff1c531c831c911c7d1c451be81b641ab619dc18d4179c1632149612c910cd),
.INIT_RAM_19(256'h02d30517075d099e0bd40df8100211ee13b5155516ca1813192f1a201ae81b86),
.INIT_RAM_1A(256'he584e729e8d0ea77ec1dedc3ef6cf11af2d1f494f666f849fa40fc4bfe690098),
.INIT_RAM_1B(256'hdbecdb13da67d9eed9acd9a2d9d4da40dae5dbbedcc7ddfbdf51e0c4e24ce3e4),
.INIT_RAM_1C(256'hf30ef183eff1ee5cecc6eb31e99ee80fe683e4fee380e20ce0a5df4fde10dced),
.INIT_RAM_1D(256'hfb4cfc1efcbefd2efd6bfd76fd50fcf8fc70fbbafadaf9d3f8a9f762f603f490),
.INIT_RAM_1E(256'hd5bed90adc53df8fe2b4e5bbe89eeb56ede1f03bf264f45cf621f7b5f918fa4a),
.INIT_RAM_1F(256'hb896b8a3b8e8b968ba25bb21bc5fbde1bfa7c1b1c3fcc684c943cc32cf47d279),
.INIT_RAM_20(256'he120de55db9fd903d683d424d1e7cfcfcdddcc14ca74c900c7b7c69bc5aec4f0),
.INIT_RAM_21(256'h096c07f10640045a0243fffffd93fb02f852f58af2adefc3ecd0e9dae6e8e3fe),
.INIT_RAM_22(256'h068207ad08ca09d40ac70b9f0c570cea0d550d920d9f0d780d1b0c860bb70aae),
.INIT_RAM_23(256'hf661f6e5f782f837f902f9e1fad3fbd6fce7fe06ff2f0061019a02d60413054e),
.INIT_RAM_24(256'hff85fe07fca0fb53fa23f912f823f757f6aff62bf5ccf591f57af584f5aff5fa),
.INIT_RAM_25(256'h16a215c314c713ac127611260fbe0e410cb20b15096d07be060d045d02b40115),
.INIT_RAM_26(256'h153015f816af175417e3185d18c0190a193a194f1948192418e2188118011761),
.INIT_RAM_27(256'h064906f107ae087f09610a510b4c0c510d5a0e670f73107d1181127e13711457),
.INIT_RAM_28(256'h087c07da073d06aa062205a8053f04e904a904810472047d04a404e5054205b9),
.INIT_RAM_29(256'h1099104f0ffc0fa10f3e0ed30e600de50d630cd80c460bae0b100a6e09c80921),
.INIT_RAM_2A(256'h0f1d0f9e1012107810ce1115114c1174118d119811951186116b1145111510dc),
.INIT_RAM_2B(256'h0789078907a507db0829088c0903098a0a1e0abc0b610c090cb20d570df70e8f),
.INIT_RAM_2C(256'h140412db11b2108d0f6e0e590d4f0c540b6b0a9509d6093008a3083207dd07a4),
.INIT_RAM_2D(256'h212620cc20601fe21f521eb01dfd1d381c641b801a8d198e1883176e1650152c),
.INIT_RAM_2E(256'h221521e321c321b321af21b621c221d221e121ee21f521f321e721cd21a6216e),
.INIT_RAM_2F(256'h2ee72df92cfa2bf02ae029cf28c327c026cb25e72516245b23b7232b22b7225b),
.INIT_RAM_30(256'h28a02a572be82d502e8b2f973073311c319331d831eb31ce3185311130782fbd),
.INIT_RAM_31(256'h05ba07b809cc0bf30e2a106f12be1513176b19c11c131e5a209522bd24cf26c7),
.INIT_RAM_32(256'hf447f4b3f52cf5b4f650f700f7c9f8abf9a8fac3fbfbfd52fec70059020903d5),
.INIT_RAM_33(256'hed7dee07ee91ef17ef9af018f08ff100f16af1cef22cf285f2dcf332f389f3e5),
.INIT_RAM_34(256'he82be847e867e88ce8b7e8ebe929e970e9c1ea1dea83eaf2eb69ebe7ec6becf3),
.INIT_RAM_35(256'he46de4c0e516e56fe5c6e61be66be6b5e6f7e733e766e793e7b9e7d9e7f6e811),
.INIT_RAM_36(256'he8d8e7d2e6e7e618e565e4cee452e3f3e3ade381e36ce36ee383e3aae3dfe421),
.INIT_RAM_37(256'h02b700e2ff0bfd33fb5df98bf7bef5faf440f293f0f4ef66edeaec83eb32e9f9),
.INIT_RAM_38(256'h175716ea1654159614b413b1128e114f0ff60e860d020b6b09c4081006500487),
.INIT_RAM_39(256'h06de08f00aee0cd20e99104011c2131e144f1554162c16d4174d179517af179a),
.INIT_RAM_3A(256'he4c0e681e85bea4dec51ee67f08bf2bbf4f5f736f97bfbc2fe09004c028804ba),
.INIT_RAM_3B(256'hded8ddd2dcf5dc47dbc9db7ddb65db82dbd2dc55dd09ddeddefde037e198e31c),
.INIT_RAM_3C(256'hf675f54df409f2adf13aefb4ee1eec7cead3e926e77ce5dae444e2c0e154e005),
.INIT_RAM_3D(256'hf6a9f7c5f8b8f984fa27faa3faf8fb27fb2ffb12fad1fa6bf9e3f938f86cf780),
.INIT_RAM_3E(256'hd57bd7d4da3bdcabdf1de18de3f5e64fe898eacaece1eedbf0b4f26af3fbf566),
.INIT_RAM_3F(256'hc462c405c3dac3e2c41ec48dc531c608c712c84dc9b8cb51cd14ceffd10cd337)) rom2(.DOA(a[2]),.DOB(b[2]),.DIA(16'd0),.DIB(16'd0),
.BLKSELA(3'd0),.BLKSELB(3'd0),.ADA({addra[9:0],4'd0}),.ADB({addrb[9:0],4'd0}),
.WREA(1'b0),.WREB(1'b0),.CLKA(clk),.CLKB(clk),.CEA(ena && addra[12:10]==3'd2),.CEB(enb && addrb[12:10]==3'd2),
.OCEA(1'b1),.OCEB(1'b1),.RESETA(1'b0),.RESETB(1'b0));
DPB #( .READ_MODE0(0),.READ_MODE1(0),.BIT_WIDTH_0(16),.BIT_WIDTH_1(16),
.INIT_RAM_00(256'he2efe0a0de6edc5dda70d8aad70ed59dd459d342d25ad1a1d116d0bad08bd089),
.INIT_RAM_01(256'h07c60647049802bc00b7fe8dfc42f9dcf760f4d2f239ef9becfcea64e7d6e558),
.INIT_RAM_02(256'h0674079308a009970a720b2e0bc70c390c810c9b0c850c3e0bc20b120a2d0913),
.INIT_RAM_03(256'hf6a7f70ef794f836f8f3f9c9fab6fbb7fccbfdedff1c0054019202d1040e0546),
.INIT_RAM_04(256'h00a5ff4bfdfffcc4fb9efa8ff999f8bef801f763f6e5f687f64bf631f637f65f),
.INIT_RAM_05(256'h135712bf120c113e10550f550e3d0d110bd20a83092707c1065504e503750209),
.INIT_RAM_06(256'h0f791049110c11c1126512f9137913e4143a1479149f14ac149f1477143313d3),
.INIT_RAM_07(256'h023302b6034e03f704b2057b065007300819090709f90aed0be00ccf0dba0e9e),
.INIT_RAM_08(256'h053f049403f1035a02ce025101e5018a0143011100f500f00102012c016d01c5),
.INIT_RAM_09(256'h0e990e4e0df40d8b0d160c950c080b710ad20a2a097c08ca0814075c06a505ef),
.INIT_RAM_0A(256'h0a7d0b2a0bcf0c6a0cf80d790de90e4a0e990ed70f030f1d0f250f1b0f000ed5),
.INIT_RAM_0B(256'h040103c403a503a403bf03f6044504ab052605b3064e06f507a5085a091209c9),
.INIT_RAM_0C(256'h130c11e910be0f8e0e5c0d2b0bff0adb09c308bb07c406e30619056804d3045b),
.INIT_RAM_0D(256'h1a4c1a861aad1abf1aba1a9d1a661a1519ab1926188817d117041621152a1422),
.INIT_RAM_0E(256'h1652161115ef15e915fd1629166916ba1719178217f2186418d5194219a71a00),
.INIT_RAM_0F(256'h26a1257d244522ff21b120611f141dcf1c971b711a61196a188e17d0173116b1),
.INIT_RAM_10(256'h223a23f3258126e0280d290629ca2a582aaf2ad02abd2a782a032962289927ac),
.INIT_RAM_11(256'hfe8a0075027e04a306df092e0b8d0df7106612d6154117a219f41c311e542058),
.INIT_RAM_12(256'hf2edf2c8f2b3f2b4f2cdf302f355f3caf462f51ff603f70ef841f99bfb1bfcc1),
.INIT_RAM_13(256'hf400f455f499f4ccf4edf4fcf4fbf4e9f4c9f49df466f427f3e4f39ff35df320),
.INIT_RAM_14(256'heabbeb46ebd9ec71ed0fedb2ee57eefeefa5f04af0ecf188f21df2a8f328f39c),
.INIT_RAM_15(256'he6cbe6bbe6b8e6c1e6d5e6f4e71ee751e78ee7d5e825e87de8dfe949e9bcea38),
.INIT_RAM_16(256'hf02fef20ee1eed2cec49eb77eab6ea06e967e8dae85ee7f3e799e74fe715e6e9),
.INIT_RAM_17(256'h04fe03ac025500fbff9dfe3efcdffb80fa25f8ccf779f62cf4e6f3a8f274f14c),
.INIT_RAM_18(256'h122a120811c9116c10f3105f0fb20eee0e130d240c230b1209f108c4078b0649),
.INIT_RAM_19(256'h054106a8080609560a970bc70ce30de80ed50fa8105f10f9117411d1120e122c),
.INIT_RAM_1A(256'hf02cf123f22cf347f473f5aef6f6f84af9a9fb11fc80fdf4ff6b00e4025c03d1),
.INIT_RAM_1B(256'hed13ec9bec34ebe2eba5eb7feb70eb7beb9eebdaec30ec9fed27edc6ee7def4a),
.INIT_RAM_1C(256'hf73ff6c5f63ef5adf511f46df3c1f30ff258f1a0f0e7f031ef7feed4ee32ed9c),
.INIT_RAM_1D(256'hf729f7aef81ef879f8c2f8f8f91cf930f933f927f90cf8e2f8aaf863f80ff7ae),
.INIT_RAM_1E(256'he3c0e568e70be8a6ea36ebb8ed2bee8cefdaf113f236f343f439f517f5def68f),
.INIT_RAM_1F(256'hd0b3d107d184d227d2efd3d9d4e4d60cd750d8abda1bdb9ddd2edecae06ee216),
.INIT_RAM_20(256'hef09edd0ec9feb7aea62e958e85ee776e6a1e5e0e533e49ce41ce3b4e363e32a),
.INIT_RAM_21(256'h016a009effbffecffdcefcbdfb9ffa74f93ff801f6bdf574f429f2dcf192f04b),
.INIT_RAM_22(256'h03fb0447048a04c004e90504050f050904f204c70489043703d1035602c60222),
.INIT_RAM_23(256'hfdf4fe35fe80fed2ff2bff8bfff0005900c5013301a2020f027b02e4034703a5),
.INIT_RAM_24(256'hff9bff34fed5fe7ffe32fdeffdb7fd89fd67fd51fd46fd47fd53fd6bfd8efdbc),
.INIT_RAM_25(256'h072706c2065705e7057104f8047a03fa037802f6027301f1017100f5007c0008),
.INIT_RAM_26(256'h0931095109680977097d097b096f095b093e091808ea08b30873082c07dc0785),
.INIT_RAM_27(256'h048904dd0534058c05e5063e069606ed0741079207de0826086908a508db090a),
.INIT_RAM_28(256'h02460237022f022d0232023f0253026e029102bb02eb0322036003a303eb0438),
.INIT_RAM_29(256'h0560052604ea04ad046f043203f603bb0382034c031902e902be02980277025c),
.INIT_RAM_2A(256'h066a0687069f06b106bd06c106bf06b606a6069006740651062a05fd05cc0597),
.INIT_RAM_2B(256'h04460447045004610479049704bb04e3050e053c056b059a05c905f606200647),
.INIT_RAM_2C(256'h0884081507a8073f06da0679061e05ca057d053804fa04c6049a0477045e044d),
.INIT_RAM_2D(256'h0e9b0e570e0f0dc10d6f0d190cbd0c5e0bfa0b920b270aba0a4a09d9096708f5),
.INIT_RAM_2E(256'h11f411b51178113f110a10d610a51075104610170fe70fb70f840f4f0f170edb),
.INIT_RAM_2F(256'h16651640161015d71596154f150214b21460140d13ba1368131712ca127f1238),
.INIT_RAM_30(256'h1065113e120a12c713751412149f1519158215d9161f165216751687168a167e),
.INIT_RAM_31(256'h0078015e024e0345044305480651075d086b09790a870b910c970d980e900f80),
.INIT_RAM_32(256'hf796f7e2f833f88bf8ebf952f9c3fa3efac3fb52fbedfc93fd44fe01fec9ff9b),
.INIT_RAM_33(256'hf370f3bdf408f451f498f4dcf51ef55ff59df5daf616f652f68ff6cdf70cf74f),
.INIT_RAM_34(256'hef3fef65ef91efc3eff9f034f074f0b7f0fef148f195f1e3f232f282f2d2f322),
.INIT_RAM_35(256'hefd5efa1ef73ef4bef29ef0ceef5eee4eed7eed1eecfeed4eedeeeedef03ef1e),
.INIT_RAM_36(256'hf70bf659f5aff50ef476f3e7f360f2e2f26cf1fef199f13cf0e6f097f050f00f),
.INIT_RAM_37(256'h053904470352025d01670072ff7ffe8ffda2fcbafbd6faf8fa21f950f887f7c5),
.INIT_RAM_38(256'h0f300f0a0ecf0e800e1e0da90d230c8c0be70b340a7409a908d407f707120628),
.INIT_RAM_39(256'h06cd07cb08bf09a80a840b510c0e0cba0d530dd90e4b0ea70eee0f200f3b0f40),
.INIT_RAM_3A(256'hf74ff7fff8bff98efa6bfb55fc4afd48fe4eff5b006c0180029403a804b905c6),
.INIT_RAM_3B(256'hf67df604f599f53df4f1f4b7f490f47bf47bf48ff4b7f4f4f546f5abf624f6b0),
.INIT_RAM_3C(256'hffcaff63feeffe6ffde4fd4ffcb3fc11fb6afac1fa18f970f8cbf82bf792f702),
.INIT_RAM_3D(256'hfd03fdb7fe5afeecff6bffd90034007c00b100d300e300e000ca00a3006b0022),
.INIT_RAM_3E(256'hec7aed92eeb1efd3f0f8f21df341f461f57df693f7a1f8a5f99ffa8dfb6dfc40),
.INIT_RAM_3F(256'he309e301e311e339e379e3d0e43ee4c2e55ae607e6c6e797e877e966ea62eb69)) rom3(.DOA(a[3]),.DOB(b[3]),.DIA(16'd0),.DIB(16'd0),
.BLKSELA(3'd0),.BLKSELB(3'd0),.ADA({addra[9:0],4'd0}),.ADB({addrb[9:0],4'd0}),
.WREA(1'b0),.WREB(1'b0),.CLKA(clk),.CLKB(clk),.CEA(ena && addra[12:10]==3'd3),.CEB(enb && addrb[12:10]==3'd3),
.OCEA(1'b1),.OCEB(1'b1),.RESETA(1'b0),.RESETB(1'b0));
DPB #( .READ_MODE0(0),.READ_MODE1(0),.BIT_WIDTH_0(16),.BIT_WIDTH_1(16),
.INIT_RAM_00(256'hf7e1f75ef6e0f669f5f8f58ff52ef4d6f487f442f407f3d6f3b0f394f382f37b),
.INIT_RAM_01(256'h002effc9ff5dfeeafe70fdf0fd6bfce2fc56fbc7fb36faa5fa13f983f8f4f869),
.INIT_RAM_02(256'h01df01ff0219022c0239023d023a022e021a01fc01d601a6016d012a00df008b),
.INIT_RAM_03(256'hfef2ff14ff39ff63ff90ffc1fff30028005d009400c900fe01320162019001ba),
.INIT_RAM_04(256'hffa8ff79ff4dff25ff02fee3fec9feb4fea5fe9bfe96fe98fe9ffeacfebefed6),
.INIT_RAM_05(256'h030c02e102b20281024d021701df01a6016b013000f500ba008000470010ffdb),
.INIT_RAM_06(256'h03c303d303df03e903ef03f103f003eb03e203d503c403b00397037a03590334),
.INIT_RAM_07(256'h0222023a0254026f028b02a702c402e202ff031c03380353036d0386039d03b1),
.INIT_RAM_08(256'h01ba01b101a901a3019f019d019e01a101a601ad01b701c401d201e301f6020b),
.INIT_RAM_09(256'h029c02920288027b026e025f025002400230021f020f01fe01ef01e001d201c5),
.INIT_RAM_0A(256'h023602470258026702760283028f029902a102a702ac02ae02ae02ac02a902a3),
.INIT_RAM_0B(256'h0194018f018c018d01900195019d01a601b201bf01ce01de01ef020002120224),
.INIT_RAM_0C(256'h033c031402ed02c702a2027f025e023e0221020601ee01d801c501b401a6019c),
.INIT_RAM_0D(256'h05d505ab0583055a0531050704de04b4048b04610437040c03e203b8038e0365),
.INIT_RAM_0E(256'h08c3088d0858082407f107bf078e075e072f070106d406a7067c0651062705fe),
.INIT_RAM_0F(256'h0b580b4b0b380b1f0b010adf0ab90a8f0a620a330a0109ce099a0964092e08f9),
.INIT_RAM_10(256'h084508ae0910096c09c00a0d0a520a900ac50af20b180b350b4b0b590b600b5f),
.INIT_RAM_11(256'h002500a4012601ab023302bb034503ce045804e0056605eb066c06e9076207d6),
.INIT_RAM_12(256'hfab2fae5fb1bfb56fb96fbdbfc25fc74fcc9fd23fd82fde6fe50febeff32ffa9),
.INIT_RAM_13(256'hf8baf8d5f8eff909f923f93df958f973f98ef9abf9caf9eafa0cfa31fa59fa84),
.INIT_RAM_14(256'hf6edf705f71ff73af757f774f792f7b1f7d0f7eef80df82bf849f866f882f89e),
.INIT_RAM_15(256'hf74af720f6fdf6def6c5f6b1f6a2f698f693f692f695f69bf6a6f6b3f6c4f6d8),
.INIT_RAM_16(256'hfca6fc2ffbbbfb4bfadffa77fa14f9b5f95bf906f8b6f86bf826f7e7f7adf778),
.INIT_RAM_17(256'h045a03ee037d030902920217019a011c009c001bff99ff18fe98fe19fd9bfd1f),
.INIT_RAM_18(256'h0791079907990790077f07650743071906e706ae066c062405d5057f052304c1),
.INIT_RAM_19(256'h037f03e1044204a004fb055205a505f3063c067f06bc06f20721074907690781),
.INIT_RAM_1A(256'hfdfafe37fe79fec0ff0cff5cffb10009006500c30124018701eb025002b5031a),
.INIT_RAM_1B(256'hfd06fcf2fce2fcd6fccdfcc9fccafcd0fcdbfcebfd01fd1cfd3dfd64fd90fdc2),
.INIT_RAM_1C(256'hfeddfec8feaffe94fe77fe58fe38fe16fdf5fdd3fdb1fd91fd71fd53fd37fd1d),
.INIT_RAM_1D(256'hfdd0fe09fe3dfe6bfe94feb6fed3feebfefcff09ff10ff13ff10ff0afefffef0),
.INIT_RAM_1E(256'hf7f4f861f8cff93cf9a9fa14fa7efae5fb49fba9fc06fc5ffcb3fd02fd4cfd90),
.INIT_RAM_1F(256'hf37ff38df3a4f3c5f3f0f423f45ff4a2f4ecf53df594f5f0f651f6b5f71df788),
.INIT_RAM_20(256'hfd3ffd20fd02fce6fcccfcb4fc9dfc89fc78fc68fc5bfc51fc49fc44fc42fc42),
.INIT_RAM_21(256'hff55ff39ff1cfefdfeddfebbfe99fe77fe54fe30fe0cfde9fdc6fda3fd81fd5f),
.INIT_RAM_22(256'h001c001d001d001c00180013000b0002fff7ffe9ffdaffc9ffb5ffa0ff89ff70),
.INIT_RAM_23(256'hff87ff91ff9cffa8ffb3ffbfffcbffd6ffe1ffecfff5ffff0007000e00140018),
.INIT_RAM_24(256'hff5aff54ff50ff4cff4aff49ff4aff4bff4eff51ff56ff5cff63ff6bff73ff7d),
.INIT_RAM_25(256'h001d000efffffff0ffe1ffd3ffc5ffb7ffa9ff9dff91ff85ff7bff71ff68ff61),
.INIT_RAM_26(256'h00db00d300cb00c200b900af00a40098008c00800073006500570049003b002c),
.INIT_RAM_27(256'h010b010a010a01090108010701050103010100fe00fb00f700f300ee00e800e2),
.INIT_RAM_28(256'h0115011301120110010f010e010d010d010c010c010c010b010b010b010b010b),
.INIT_RAM_29(256'h0136013501330131012f012d012b0129012601240122011f011d011b01190117),
.INIT_RAM_2A(256'h011b012001240128012b012e0131013301350136013701380138013801380137),
.INIT_RAM_2B(256'h00c400c900ce00d300d800de00e400e900ef00f500fb01010107010c01110116),
.INIT_RAM_2C(256'h00cd00c600c100bc00b900b600b400b200b200b200b300b400b600b900bc00c0),
.INIT_RAM_2D(256'h01a701930181016e015d014c013d012d011f0112010500fa00ef00e500dc00d4),
.INIT_RAM_2E(256'h02f902e502d102bc02a70292027c02660250023a0224020e01f901e401cf01ba),
.INIT_RAM_2F(256'h038b038e0390038f038d03880382037b03710367035b034d033e032e031d030b),
.INIT_RAM_30(256'h02470269028902a802c502e002f903110327033a034c035c03690375037e0385),
.INIT_RAM_31(256'hffc0ffea0014003e0068009300bd00e70111013b0164018c01b301da01ff0224),
.INIT_RAM_32(256'hfd97fdb2fdcefdebfe09fe28fe48fe6afe8cfeb0fed4fef9ff20ff47ff6fff97),
.INIT_RAM_33(256'hfc6efc7bfc88fc95fca4fcb3fcc3fcd4fce6fcf9fd0cfd21fd36fd4dfd65fd7d),
.INIT_RAM_34(256'hfc16fc15fc14fc15fc17fc1afc1dfc22fc27fc2dfc34fc3cfc45fc4efc58fc63),
.INIT_RAM_35(256'hfcf2fcd8fcc0fca9fc94fc81fc70fc60fc52fc46fc3bfc31fc29fc22fc1dfc19),
.INIT_RAM_36(256'hff5aff2cfefefed1fea4fe79fe4efe25fdfdfdd6fdb1fd8dfd6bfd4afd2bfd0e),
.INIT_RAM_37(256'h021901f601d001a901810157012c010000d200a5007600470018ffe8ffb9ff89),
.INIT_RAM_38(256'h03120316031703160312030b030102f502e702d502c202ab02930277025a023b),
.INIT_RAM_39(256'h01c901e702040221023d02580272028b02a102b702ca02dc02eb02f80303030c),
.INIT_RAM_3A(256'h001e0030004400590070008800a200bc00d800f501120130014e016d018b01aa),
.INIT_RAM_3B(256'hffd6ffd0ffcbffc7ffc4ffc3ffc3ffc4ffc8ffccffd3ffdbffe5fff1fffe000d),
.INIT_RAM_3C(256'h0053004f004a0044003d0035002d0024001b00110008fffffff5ffecffe4ffdc),
.INIT_RAM_3D(256'hffb3ffcbffe0fff40006001600250031003c0045004c00510054005600560055),
.INIT_RAM_3E(256'hfdaafdcdfdf1fe14fe38fe5cfe7ffea2fec5fee7ff08ff28ff46ff64ff80ff9a),
.INIT_RAM_3F(256'hfc45fc4bfc54fc5ffc6cfc7cfc8ffca3fcbafcd3fcedfd09fd27fd46fd67fd88)) rom4(.DOA(a[4]),.DOB(b[4]),.DIA(16'd0),.DIB(16'd0),
.BLKSELA(3'd0),.BLKSELB(3'd0),.ADA({addra[9:0],4'd0}),.ADB({addrb[9:0],4'd0}),
.WREA(1'b0),.WREB(1'b0),.CLKA(clk),.CLKB(clk),.CEA(ena && addra[12:10]==3'd4),.CEB(enb && addrb[12:10]==3'd4),
.OCEA(1'b1),.OCEB(1'b1),.RESETA(1'b0),.RESETB(1'b0));
DPB #( .READ_MODE0(0),.READ_MODE1(0),.BIT_WIDTH_0(16),.BIT_WIDTH_1(16),
.INIT_RAM_00(256'hff53ff52ff50ff50ff4fff4fff4fff50ff51ff52ff54ff56ff59ff5cff5fff63),
.INIT_RAM_01(256'hff7eff7bff78ff75ff72ff6fff6cff69ff66ff63ff60ff5dff5bff59ff56ff55),
.INIT_RAM_02(256'hff99ff99ff98ff97ff96ff95ff94ff92ff91ff8fff8dff8bff88ff86ff83ff80),
.INIT_RAM_03(256'hff8eff8fff91ff92ff93ff94ff95ff96ff97ff98ff98ff99ff99ff9aff9aff99),
.INIT_RAM_04(256'hff85ff84ff84ff84ff84ff84ff85ff85ff86ff87ff88ff89ff8aff8bff8cff8d),
.INIT_RAM_05(256'hffa9ffa5ffa1ff9eff9bff98ff95ff93ff90ff8eff8cff8aff89ff88ff86ff86),
.INIT_RAM_06(256'hfff2ffedffe8ffe3ffdeffd9ffd4ffd0ffcbffc6ffc2ffbdffb9ffb5ffb1ffad),
.INIT_RAM_07(256'h003c00380033002f002b00260022001d00180014000f000a00050001fffcfff7),
.INIT_RAM_08(256'h00740071006e006b006800650062005e005b005700540050004c004800440040),
.INIT_RAM_09(256'h008e008d008c008b008a008900880086008500830081007f007d007b00790076),
.INIT_RAM_0A(256'h008600870089008a008b008c008d008d008e008e008f008f008f008f008f008e),
.INIT_RAM_0B(256'h006400660068006b006d00700072007400770079007b007d007f008100830084),
.INIT_RAM_0C(256'h004700480049004a004b004c004e00500052005400560058005a005c005f0061),
.INIT_RAM_0D(256'h0050004e004d004b004a00490048004700460046004600450045004500460046),
.INIT_RAM_0E(256'h006a0069006700660065006300610060005e005c005a00580057005500530051),
.INIT_RAM_0F(256'h005f0062006400660068006a006b006c006d006d006d006d006d006c006c006b),
.INIT_RAM_10(256'h000b0012001900200027002d00330039003e00440049004d005100550059005c),
.INIT_RAM_11(256'hff83ff8cff95ff9dffa6ffafffb8ffc1ffc9ffd2ffdaffe3ffebfff3fffb0003),
.INIT_RAM_12(256'hff08ff0eff15ff1cff23ff2aff31ff39ff41ff49ff51ff59ff61ff69ff72ff7a),
.INIT_RAM_13(256'hfec7fec8fecbfecdfed0fed3fed6fedafedefee2fee7feecfef1fef6fefcff02),
.INIT_RAM_14(256'hfeddfed8fed5fed1fecefecbfec9fec7fec6fec5fec4fec3fec3fec4fec4fec5),
.INIT_RAM_15(256'hff50ff47ff3dff34ff2cff23ff1bff13ff0cff05fefefef7fef1feecfee6fee1),
.INIT_RAM_16(256'h0004fff8ffecffe0ffd4ffc8ffbdffb1ffa6ff9aff8fff84ff79ff6fff64ff5a),
.INIT_RAM_17(256'h00a900a10098008f0086007d00730069005e00540049003d00320027001b000f),
.INIT_RAM_18(256'h00ee00ed00eb00e900e700e400e100de00da00d500d000cb00c500be00b800b0),
.INIT_RAM_19(256'h00d400d700da00dd00e000e200e500e700e900eb00ec00ed00ee00ee00ef00ee),
.INIT_RAM_1A(256'h00a500a700aa00ac00af00b100b400b700ba00bd00c000c400c700ca00ce00d1),
.INIT_RAM_1B(256'h009c009b009b009b009b009b009b009b009c009c009d009e009f00a000a200a3),
.INIT_RAM_1C(256'h0099009b009c009d009e009e009f009f009f009f009e009e009e009d009d009c),
.INIT_RAM_1D(256'h0056005c00620068006e00740079007d00820086008a008d0090009300950097),
.INIT_RAM_1E(256'hffd4ffddffe5ffeefff6ffff000700100018002100290031003900400048004f),
.INIT_RAM_1F(256'hff67ff6bff70ff76ff7bff81ff88ff8eff95ff9cffa4ffabffb3ffbbffc3ffcc),
.INIT_RAM_20(256'hff93ff91ff8fff8dff8bff8aff89ff88ff88ff87ff87ff87ff88ff89ff8aff8b),
.INIT_RAM_21(256'hffc0ffbdffbaffb7ffb4ffb1ffaeffabffa8ffa5ffa2ff9fff9dff9aff97ff95),
.INIT_RAM_22(256'hffddffdcffdbffdaffd9ffd8ffd6ffd4ffd3ffd1ffcfffcdffcaffc8ffc5ffc3),
.INIT_RAM_23(256'hffd9ffdaffdaffdbffdbffdcffddffddffddffdeffdeffdeffdeffdeffdeffdd),
.INIT_RAM_24(256'hffd4ffd4ffd4ffd3ffd3ffd4ffd4ffd4ffd4ffd5ffd5ffd6ffd6ffd7ffd8ffd8),
.INIT_RAM_25(256'hffe7ffe5ffe4ffe2ffe0ffdfffddffdcffdbffd9ffd8ffd7ffd6ffd6ffd5ffd5),
.INIT_RAM_26(256'h00090007000500020000fffefffcfffafff8fff5fff3fff1ffefffedffebffe9),
.INIT_RAM_27(256'h00270025002400220020001e001d001b00190017001500130011000f000d000b),
.INIT_RAM_28(256'h003e003d003b003a0039003700360035003300320030002f002d002c002a0029),
.INIT_RAM_29(256'h004e004d004c004c004b004a004900480047004600450044004300420040003f),
.INIT_RAM_2A(256'h004d004e004e004f004f004f005000500050005000500050004f004f004f004e),
.INIT_RAM_2B(256'h003c003d003e004000410042004400450046004700480049004a004b004c004c),
.INIT_RAM_2C(256'h002f002f002f003000300031003100320033003400350036003700380039003b),
.INIT_RAM_2D(256'h003c003a0038003700360034003300320032003100300030002f002f002f002f),
.INIT_RAM_2E(256'h005900580056005400520051004f004d004b00490047004500430041003f003d),
.INIT_RAM_2F(256'h005e005f006000610061006200620062006100610060005f005e005d005c005b),
.INIT_RAM_30(256'h002e00320036003b003f004200460049004d004f0052005500570059005b005d),
.INIT_RAM_31(256'hffdbffe1ffe6ffebfff1fff6fffc00010006000b00110016001b002000250029),
.INIT_RAM_32(256'hff90ff94ff98ff9cffa0ffa4ffa9ffaeffb2ffb7ffbcffc1ffc6ffcbffd0ffd6),
.INIT_RAM_33(256'hff68ff69ff6aff6cff6eff70ff72ff74ff77ff7aff7cff7fff82ff86ff89ff8d),
.INIT_RAM_34(256'hff6aff68ff67ff66ff65ff64ff64ff63ff63ff63ff63ff63ff64ff64ff65ff66),
.INIT_RAM_35(256'hff9cff97ff93ff8fff8bff87ff83ff80ff7dff7aff77ff74ff72ff6fff6dff6b),
.INIT_RAM_36(256'hfff6fff0ffeaffe4ffdeffd8ffd2ffccffc6ffc1ffbbffb6ffb0ffabffa6ffa1),
.INIT_RAM_37(256'h004c00480043003f003a00350030002a0025001f001a0014000e00080002fffc),
.INIT_RAM_38(256'h0069006900690069006800670066006500630061005f005c005900560053004f),
.INIT_RAM_39(256'h004d0050005200550057005a005c005e00600062006400650066006700680069),
.INIT_RAM_3A(256'h002a002c002d002f00300032003400370039003b003e0040004300450048004b),
.INIT_RAM_3B(256'h0026002500250024002400240024002400240024002500250026002700280029),
.INIT_RAM_3C(256'h002c002d002d002d002d002d002c002c002b002b002a00290029002800270027),
.INIT_RAM_3D(256'h000c000f001300160019001c001e002000220024002600280029002a002b002c),
.INIT_RAM_3E(256'hffc4ffc8ffcdffd2ffd7ffdcffe1ffe5ffeaffeffff3fff8fffc000000040008),
.INIT_RAM_3F(256'hff8cff8eff90ff93ff95ff98ff9bff9fffa2ffa6ffaaffaeffb2ffb6ffbaffbf)) rom5(.DOA(a[5]),.DOB(b[5]),.DIA(16'd0),.DIB(16'd0),
.BLKSELA(3'd0),.BLKSELB(3'd0),.ADA({addra[9:0],4'd0}),.ADB({addrb[9:0],4'd0}),
.WREA(1'b0),.WREB(1'b0),.CLKA(clk),.CLKB(clk),.CEA(ena && addra[12:10]==3'd5),.CEB(enb && addrb[12:10]==3'd5),
.OCEA(1'b1),.OCEB(1'b1),.RESETA(1'b0),.RESETB(1'b0));
DPB #( .READ_MODE0(0),.READ_MODE1(0),.BIT_WIDTH_0(16),.BIT_WIDTH_1(16),
.INIT_RAM_00(256'h0000000000000000000000000000000000000000000000000000000000000000),
.INIT_RAM_01(256'h0000000000000000000000000000000000000000000000000000000000000000),
.INIT_RAM_02(256'h0000000000000000000000000000000000000000000000000000000000000000),
.INIT_RAM_03(256'h0000000000000000000000000000000000000000000000000000000000000000),
.INIT_RAM_04(256'h0000000000000000000000000000000000000000000000000000000000000000),
.INIT_RAM_05(256'h0000000000000000000000000000000000000000000000000000000000000000),
.INIT_RAM_06(256'h0000000000000000000000000000000000000000000000000000000000000000),
.INIT_RAM_07(256'h0000000000000000000000000000000000000000000000000000000000000000),
.INIT_RAM_08(256'h0000000000000000000000000000000000000000000000000000000000000000),
.INIT_RAM_09(256'h0000000000000000000000000000000000000000000000000000000000000000),
.INIT_RAM_0A(256'h0000000000000000000000000000000000000000000000000000000000000000),
.INIT_RAM_0B(256'h0000000000000000000000000000000000000000000000000000000000000000),
.INIT_RAM_0C(256'h0000000000000000000000000000000000000000000000000000000000000000),
.INIT_RAM_0D(256'h0000000000000000000000000000000000000000000000000000000000000000),
.INIT_RAM_0E(256'h0000000000000000000000000000000000000000000000000000000000000000),
.INIT_RAM_0F(256'h0000000000000000000000000000000000000000000000000000000000000000),
.INIT_RAM_10(256'h0000000000000000000000000000000000000000000000000000000000000000),
.INIT_RAM_11(256'h0000000000000000000000000000000000000000000000000000000000000000),
.INIT_RAM_12(256'h0000000000000000000000000000000000000000000000000000000000000000),
.INIT_RAM_13(256'h0000000000000000000000000000000000000000000000000000000000000000),
.INIT_RAM_14(256'h0000000000000000000000000000000000000000000000000000000000000000),
.INIT_RAM_15(256'h0000000000000000000000000000000000000000000000000000000000000000),
.INIT_RAM_16(256'h0000000000000000000000000000000000000000000000000000000000000000),
.INIT_RAM_17(256'h0000000000000000000000000000000000000000000000000000000000000000),
.INIT_RAM_18(256'h0000000000000000000000000000000000000000000000000000000000000000),
.INIT_RAM_19(256'h0000000000000000000000000000000000000000000000000000000000000000),
.INIT_RAM_1A(256'h0000000000000000000000000000000000000000000000000000000000000000),
.INIT_RAM_1B(256'h0000000000000000000000000000000000000000000000000000000000000000),
.INIT_RAM_1C(256'h0000000000000000000000000000000000000000000000000000000000000000),
.INIT_RAM_1D(256'h0000000000000000000000000000000000000000000000000000000000000000),
.INIT_RAM_1E(256'h0000000000000000000000000000000000000000000000000000000000000000),
.INIT_RAM_1F(256'h0000000000000000000000000000000000000000000000000000000000000000),
.INIT_RAM_20(256'h095608b70818077906da063a059b04fc045c03bd031e027e01df013f00a00000),
.INIT_RAM_21(256'h1334129711fa115d10c010220f850ee70e490dab0d0d0c6f0bd00b320a9309f4),
.INIT_RAM_22(256'h1ce31c4a1bb01b171a7d19e3194818ad1813177816dc164115a51509146d13d0),
.INIT_RAM_23(256'h264a25b62522248d23f8236322cd223721a1210a20731fdc1f441eac1e141d7b),
.INIT_RAM_24(256'h2f532ec62e382daa2d1b2c8c2bfc2b6c2adc2a4b29ba292828962804277126de),
.INIT_RAM_25(256'h37e8376236dc365635cf354734bf343733ae3324329a320f318430f9306d2fe0),
.INIT_RAM_26(256'h3ff33f763ef93e7c3dfe3d7f3d003c803c003b7f3afd3a7b39f8397538f1386d),
.INIT_RAM_27(256'h476046ee467b46084594452044aa443543be434742cf425641dd416440e9406e),
.INIT_RAM_28(256'h4e1d4db64d4f4ce74c7f4c164bac4b414ad54a6949fc498e492048b1484147d1),
.INIT_RAM_29(256'h541953bf5365530952ad525051f25193513450d4507350114fae4f4b4ee74e82),
.INIT_RAM_2A(256'h594658fa58ac585e580f57bf576f571d56cb5677562355ce5578552254ca5472),
.INIT_RAM_2B(256'h5d975d595d1a5cd95c985c565c135bd05b8b5b465aff5ab85a705a2759dd5992),
.INIT_RAM_2C(256'h610260d260a16070603d600a5fd55fa05f6a5f335efb5ec25e885e4d5e115dd5),
.INIT_RAM_2D(256'h637d635c633b631862f562d062ab6285625e6235620c61e261b7618b615e6130),
.INIT_RAM_2E(256'h650364f264e064cc64b864a3648e6477645f6446642c641163f563d963bb639c),
.INIT_RAM_2F(256'h6590658e658c65886584657e657865716568655f6555654a653d653065226513),
.INIT_RAM_30(256'h65226530653d654a6555655f656865716578657e65846588658c658e65906590),
.INIT_RAM_31(256'h63bb63d963f56411642c6446645f6477648e64a364b864cc64e064f265036513),
.INIT_RAM_32(256'h615e618b61b761e2620c6235625e628562ab62d062f56318633b635c637d639c),
.INIT_RAM_33(256'h5e115e4d5e885ec25efb5f335f6a5fa05fd5600a603d607060a160d261026130),
.INIT_RAM_34(256'h59dd5a275a705ab85aff5b465b8b5bd05c135c565c985cd95d1a5d595d975dd5),
.INIT_RAM_35(256'h54ca5522557855ce5623567756cb571d576f57bf580f585e58ac58fa59465992),
.INIT_RAM_36(256'h4ee74f4b4fae5011507350d45134519351f2525052ad5309536553bf54195472),
.INIT_RAM_37(256'h484148b14920498e49fc4a694ad54b414bac4c164c7f4ce74d4f4db64e1d4e82),
.INIT_RAM_38(256'h40e9416441dd425642cf434743be443544aa452045944608467b46ee476047d1),
.INIT_RAM_39(256'h38f1397539f83a7b3afd3b7f3c003c803d003d7f3dfe3e7c3ef93f763ff3406e),
.INIT_RAM_3A(256'h306d30f93184320f329a332433ae343734bf354735cf365636dc376237e8386d),
.INIT_RAM_3B(256'h277128042896292829ba2a4b2adc2b6c2bfc2c8c2d1b2daa2e382ec62f532fe0),
.INIT_RAM_3C(256'h1e141eac1f441fdc2073210a21a1223722cd236323f8248d252225b6264a26de),
.INIT_RAM_3D(256'h146d150915a5164116dc1778181318ad194819e31a7d1b171bb01c4a1ce31d7b),
.INIT_RAM_3E(256'h0a930b320bd00c6f0d0d0dab0e490ee70f85102210c0115d11fa1297133413d0),
.INIT_RAM_3F(256'h00a0013f01df027e031e03bd045c04fc059b063a06da0779081808b7095609f4)) rom6(.DOA(a[6]),.DOB(b[6]),.DIA(16'd0),.DIB(16'd0),
.BLKSELA(3'd0),.BLKSELB(3'd0),.ADA({addra[9:0],4'd0}),.ADB({addrb[9:0],4'd0}),
.WREA(1'b0),.WREB(1'b0),.CLKA(clk),.CLKB(clk),.CEA(ena && addra[12:10]==3'd6),.CEB(enb && addrb[12:10]==3'd6),
.OCEA(1'b1),.OCEB(1'b1),.RESETA(1'b0),.RESETB(1'b0));
DPB #( .READ_MODE0(0),.READ_MODE1(0),.BIT_WIDTH_0(16),.BIT_WIDTH_1(16),
.INIT_RAM_00(256'hf6aaf749f7e8f887f926f9c6fa65fb04fba4fc43fce2fd82fe21fec1ff600000),
.INIT_RAM_01(256'heccced69ee06eea3ef40efdef07bf119f1b7f255f2f3f391f430f4cef56df60c),
.INIT_RAM_02(256'he31de3b6e450e4e9e583e61de6b8e753e7ede888e924e9bfea5beaf7eb93ec30),
.INIT_RAM_03(256'hd9b6da4adadedb73dc08dc9ddd33ddc9de5fdef6df8de024e0bce154e1ece285),
.INIT_RAM_04(256'hd0add13ad1c8d256d2e5d374d404d494d524d5b5d646d6d8d76ad7fcd88fd922),
.INIT_RAM_05(256'hc818c89ec924c9aaca31cab9cb41cbc9cc52ccdccd66cdf1ce7ccf07cf93d020),
.INIT_RAM_06(256'hc00dc08ac107c184c202c281c300c380c400c481c503c585c608c68bc70fc793),
.INIT_RAM_07(256'hb8a0b912b985b9f8ba6cbae0bb56bbcbbc42bcb9bd31bdaabe23be9cbf17bf92),
.INIT_RAM_08(256'hb1e3b24ab2b1b319b381b3eab454b4bfb52bb597b604b672b6e0b74fb7bfb82f),
.INIT_RAM_09(256'habe7ac41ac9bacf7ad53adb0ae0eae6daeccaf2caf8dafefb052b0b5b119b17e),
.INIT_RAM_0A(256'ha6baa706a754a7a2a7f1a841a891a8e3a935a989a9ddaa32aa88aadeab36ab8e),
.INIT_RAM_0B(256'ha269a2a7a2e6a327a368a3aaa3eda430a475a4baa501a548a590a5d9a623a66e),
.INIT_RAM_0C(256'h9efe9f2e9f5f9f909fc39ff6a02ba060a096a0cda105a13ea178a1b3a1efa22b),
.INIT_RAM_0D(256'h9c839ca49cc59ce89d0b9d309d559d7b9da29dcb9df49e1e9e499e759ea29ed0),
.INIT_RAM_0E(256'h9afd9b0e9b209b349b489b5d9b729b899ba19bba9bd49bef9c0b9c279c459c64),
.INIT_RAM_0F(256'h9a709a729a749a789a7c9a829a889a8f9a989aa19aab9ab69ac39ad09ade9aed),
.INIT_RAM_10(256'h9ade9ad09ac39ab69aab9aa19a989a8f9a889a829a7c9a789a749a729a709a70),
.INIT_RAM_11(256'h9c459c279c0b9bef9bd49bba9ba19b899b729b5d9b489b349b209b0e9afd9aed),
.INIT_RAM_12(256'h9ea29e759e499e1e9df49dcb9da29d7b9d559d309d0b9ce89cc59ca49c839c64),
.INIT_RAM_13(256'ha1efa1b3a178a13ea105a0cda096a060a02b9ff69fc39f909f5f9f2e9efe9ed0),
.INIT_RAM_14(256'ha623a5d9a590a548a501a4baa475a430a3eda3aaa368a327a2e6a2a7a269a22b),
.INIT_RAM_15(256'hab36aadeaa88aa32a9dda989a935a8e3a891a841a7f1a7a2a754a706a6baa66e),
.INIT_RAM_16(256'hb119b0b5b052afefaf8daf2caeccae6dae0eadb0ad53acf7ac9bac41abe7ab8e),
.INIT_RAM_17(256'hb7bfb74fb6e0b672b604b597b52bb4bfb454b3eab381b319b2b1b24ab1e3b17e),
.INIT_RAM_18(256'hbf17be9cbe23bdaabd31bcb9bc42bbcbbb56bae0ba6cb9f8b985b912b8a0b82f),
.INIT_RAM_19(256'hc70fc68bc608c585c503c481c400c380c300c281c202c184c107c08ac00dbf92),
.INIT_RAM_1A(256'hcf93cf07ce7ccdf1cd66ccdccc52cbc9cb41cab9ca31c9aac924c89ec818c793),
.INIT_RAM_1B(256'hd88fd7fcd76ad6d8d646d5b5d524d494d404d374d2e5d256d1c8d13ad0add020),
.INIT_RAM_1C(256'he1ece154e0bce024df8ddef6de5fddc9dd33dc9ddc08db73dadeda4ad9b6d922),
.INIT_RAM_1D(256'heb93eaf7ea5be9bfe924e888e7ede753e6b8e61de583e4e9e450e3b6e31de285),
.INIT_RAM_1E(256'hf56df4cef430f391f2f3f255f1b7f119f07befdeef40eea3ee06ed69ecccec30),
.INIT_RAM_1F(256'hff60fec1fe21fd82fce2fc43fba4fb04fa65f9c6f926f887f7e8f749f6aaf60c),
.INIT_RAM_20(256'h6536641b622f5f645bb25715518d4b2043da3bc832fe29951fa815540abc0000),
.INIT_RAM_21(256'h4da34e2b4f10504f51e053ba55d158125a6b5cc75f0b612162ec6454653d6590),
.INIT_RAM_22(256'h5bf95b9d5b045a32592d57fd56ab554553d6526c51174fe54ee24e1d4da14d76),
.INIT_RAM_23(256'h515b51a3521952ba53815468556556715780588a59825a5f5b175ba35bfa5c18),
.INIT_RAM_24(256'h5a0f59d2596f58e75841578256b055d454f6541e535552a3520f51a0515a5143),
.INIT_RAM_25(256'h526f52a552fe5377540a54b3556c562d56f057ac585b58f5597459d45a0f5a23),
.INIT_RAM_26(256'h5975594258ef587f57f6575956ae55fc5549549c53fc536f52fb52a4526f525d),
.INIT_RAM_27(256'h52b452e6533753a4542954c15566561256be576357fc588258f1594359755987),
.INIT_RAM_28(256'h5975594358f1588257fc576356be5612556654c1542953a4533752e652b452a3),
.INIT_RAM_29(256'h526f52a452fb536f53fc549c554955fc56ae575957f6587f58ef594259755987),
.INIT_RAM_2A(256'h5a0f59d4597458f5585b57ac56f0562d556c54b3540a537752fe52a5526f525d),
.INIT_RAM_2B(256'h515a51a0520f52a35355541e54f655d456b05782584158e7596f59d25a0f5a23),
.INIT_RAM_2C(256'h5bfa5ba35b175a5f5982588a5780567155655468538152ba521951a3515b5143),
.INIT_RAM_2D(256'h4da14e1d4ee24fe55117526c53d6554556ab57fd592d5a325b045b9d5bf95c18),
.INIT_RAM_2E(256'h653d645462ec61215f0b5cc75a6b581255d153ba51e0504f4f104e2b4da34d76),
.INIT_RAM_2F(256'h0abc15541fa8299532fe3bc843da4b20518d57155bb25f64622f641b65366590),
.INIT_RAM_30(256'h9aca9be59dd1a09ca44ea8ebae73b4e0bc26c438cd02d66be058eaacf5440000),
.INIT_RAM_31(256'hb25db1d5b0f0afb1ae20ac46aa2fa7eea595a339a0f59edf9d149bac9ac39a70),
.INIT_RAM_32(256'ha407a463a4fca5cea6d3a803a955aabbac2aad94aee9b01bb11eb1e3b25fb28a),
.INIT_RAM_33(256'haea5ae5dade7ad46ac7fab98aa9ba98fa880a776a67ea5a1a4e9a45da406a3e8),
.INIT_RAM_34(256'ha5f1a62ea691a719a7bfa87ea950aa2cab0aabe2acabad5dadf1ae60aea6aebd),
.INIT_RAM_35(256'had91ad5bad02ac89abf6ab4daa94a9d3a910a854a7a5a70ba68ca62ca5f1a5dd),
.INIT_RAM_36(256'ha68ba6bea711a781a80aa8a7a952aa04aab7ab64ac04ac91ad05ad5cad91ada3),
.INIT_RAM_37(256'had4cad1aacc9ac5cabd7ab3faa9aa9eea942a89da804a77ea70fa6bda68ba679),
.INIT_RAM_38(256'ha68ba6bda70fa77ea804a89da942a9eeaa9aab3fabd7ac5cacc9ad1aad4cad5d),
.INIT_RAM_39(256'had91ad5cad05ac91ac04ab64aab7aa04a952a8a7a80aa781a711a6bea68ba679),
.INIT_RAM_3A(256'ha5f1a62ca68ca70ba7a5a854a910a9d3aa94ab4dabf6ac89ad02ad5bad91ada3),
.INIT_RAM_3B(256'haea6ae60adf1ad5dacababe2ab0aaa2ca950a87ea7bfa719a691a62ea5f1a5dd),
.INIT_RAM_3C(256'ha406a45da4e9a5a1a67ea776a880a98faa9bab98ac7fad46ade7ae5daea5aebd),
.INIT_RAM_3D(256'hb25fb1e3b11eb01baee9ad94ac2aaabba955a803a6d3a5cea4fca463a407a3e8),
.INIT_RAM_3E(256'h9ac39bac9d149edfa0f5a339a595a7eeaa2fac46ae20afb1b0f0b1d5b25db28a),
.INIT_RAM_3F(256'hf544eaace058d66bcd02c438bc26b4e0ae73a8eba44ea09c9dd19be59aca9a70)) rom7(.DOA(a[7]),.DOB(b[7]),.DIA(16'd0),.DIB(16'd0),
.BLKSELA(3'd0),.BLKSELB(3'd0),.ADA({addra[9:0],4'd0}),.ADB({addrb[9:0],4'd0}),
.WREA(1'b0),.WREB(1'b0),.CLKA(clk),.CLKB(clk),.CEA(ena && addra[12:10]==3'd7),.CEB(enb && addrb[12:10]==3'd7),
.OCEA(1'b1),.OCEB(1'b1),.RESETA(1'b0),.RESETB(1'b0));
`undef APPROVED_NATIVE_ROM
`endif
endmodule
