crh2007530/fpga-multitimbral-instrument/(commit log)

2026-11-03 提交电子乐器工程、手机端与仿真代码
2026-11-03 补充技术文档与实测结果
